AWenzel83/FPGA-Dev/Doc/FPGA_devel.png

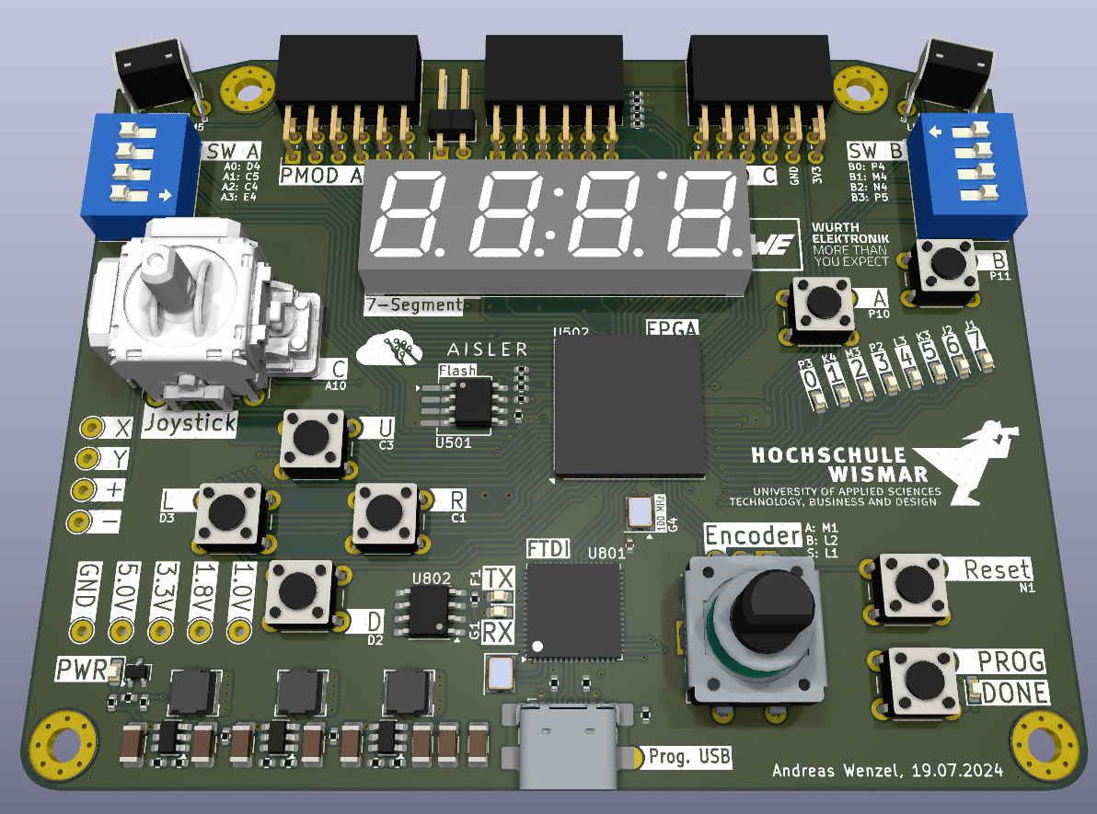
Doc/FPGA_devel.png
