AWenzel83/FPGA-Dev/README.md

# FPGA-Dev
Design and Supportfiles for the FPGA-Dev-Board used in the FPGA-Classes at the HS-Wismar
