AWenzel83/FPGA-Dev/KiCad/steps/RKJXV122400R.STEP

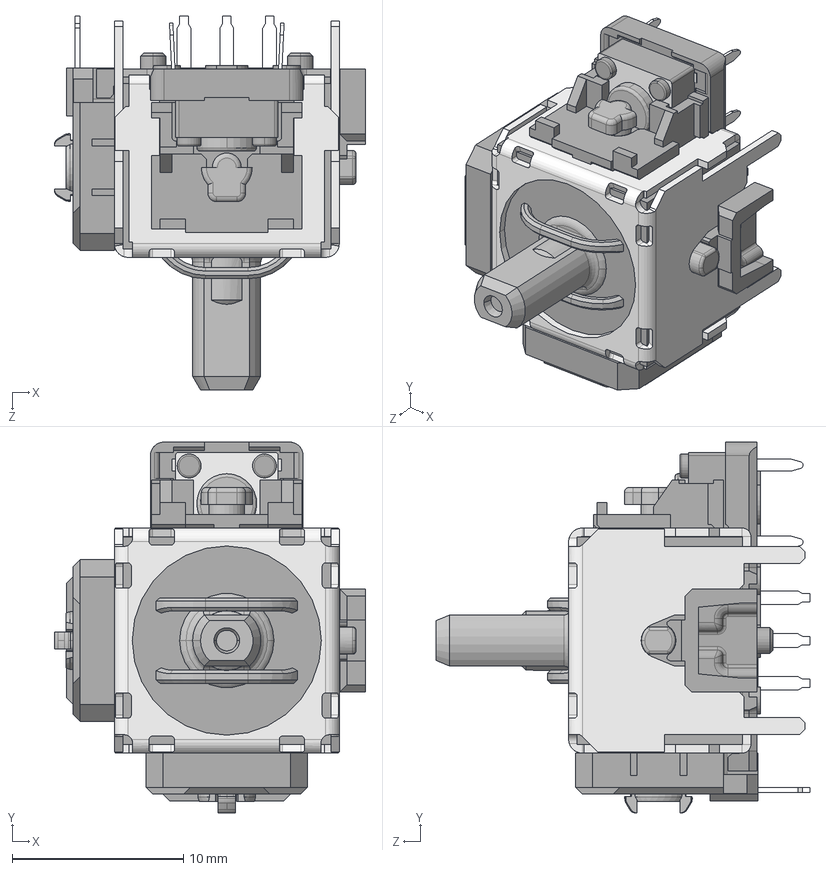
[picture p2: CAD file, 2026-05-18]
KiCad/steps/RKJXV122400R.STEP
18.2 x 21.7 x 21.9 mm
