AWenzel83/FPGA-Dev/KiCad/steps/Download_STP_490107670612 (rev1).stp

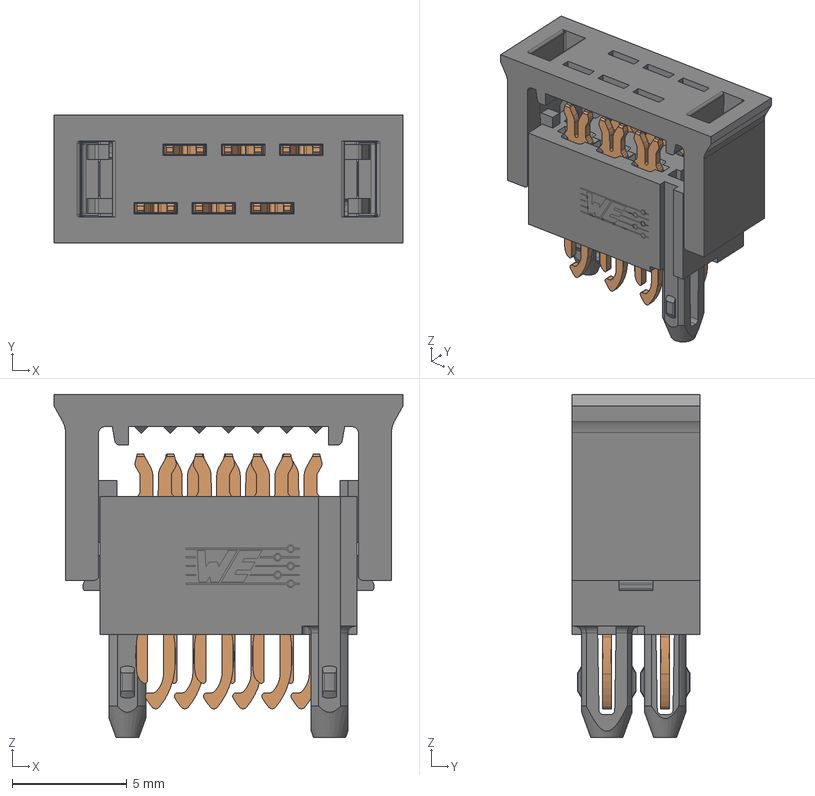
[picture p3: CAD file, 2026-05-18]
KiCad/steps/Download_STP_490107670612 (rev1).stp
15.2 x 5.60 x 15.0 mm
CT422_00.4.1.1_0 x 6
BS698_6_0
BS697_6_0
