AWenzel83/FPGA-Dev/KiCad/steps/Download_STP_693071010811 (rev1).stp

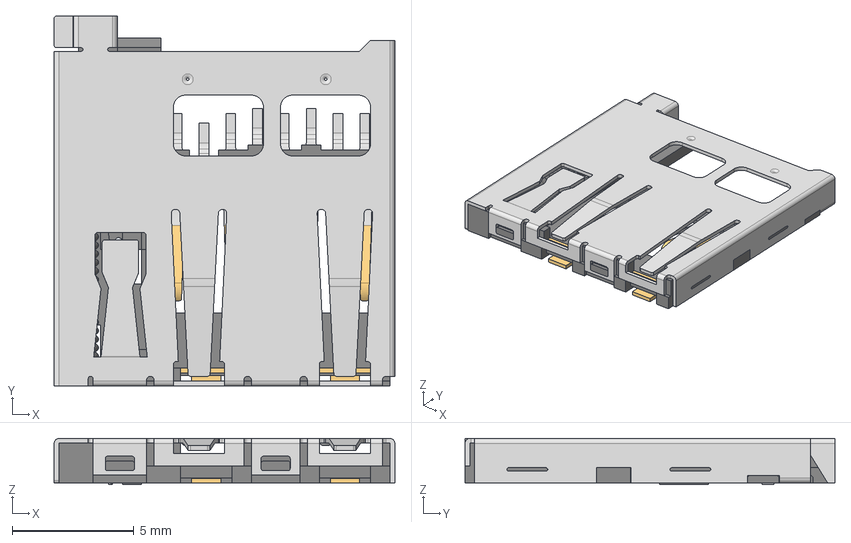
[picture p4: CAD file, 2026-05-18]
KiCad/steps/Download_STP_693071010811 (rev1).stp
14.0 x 15.2 x 1.90 mm
693071010811_COULISSEAU
693071010811_CONTACT x 8
693071010811_AGRAPHE
693071010811_RESSORT
693071010811_CACHE
693071010811_LAME
693071010811_MASSE
