AWenzel83/FPGA-Dev/KiCad/steps/MicroSD_Card.step

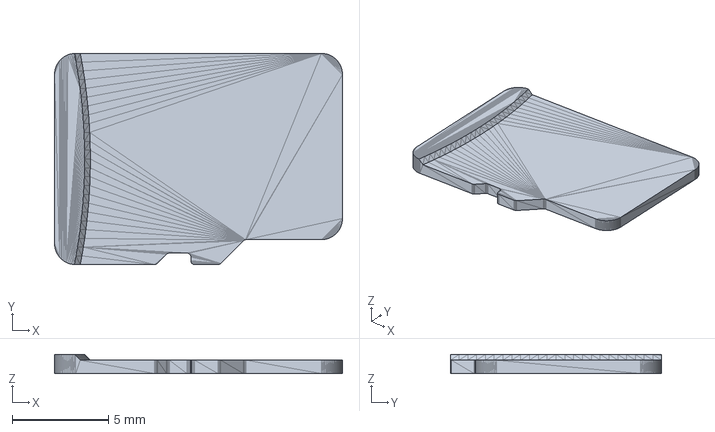
[picture p5: CAD file, 2026-05-18]
KiCad/steps/MicroSD_Card.step
15.0 x 11.0 x 1.00 mm
