AWenzel83/FPGA-Dev/KiCad/steps/USB4110GFA.step

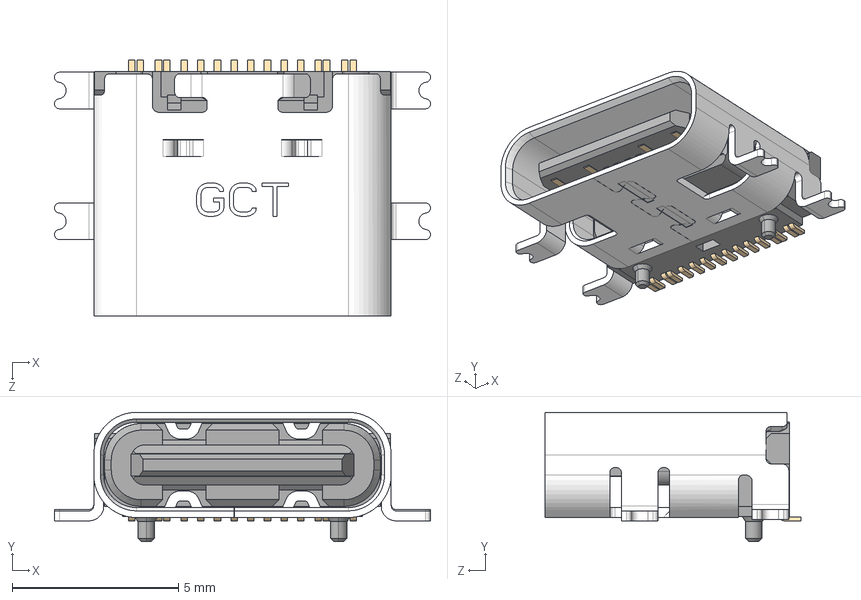
[picture p6: CAD file, 2025-10-09]
KiCad/steps/USB4110GFA.step
11.3 x 3.89 x 7.70 mm
