AWenzel83/FPGA-Dev/KiCad/steps/STP_629722000214 (rev1).stp

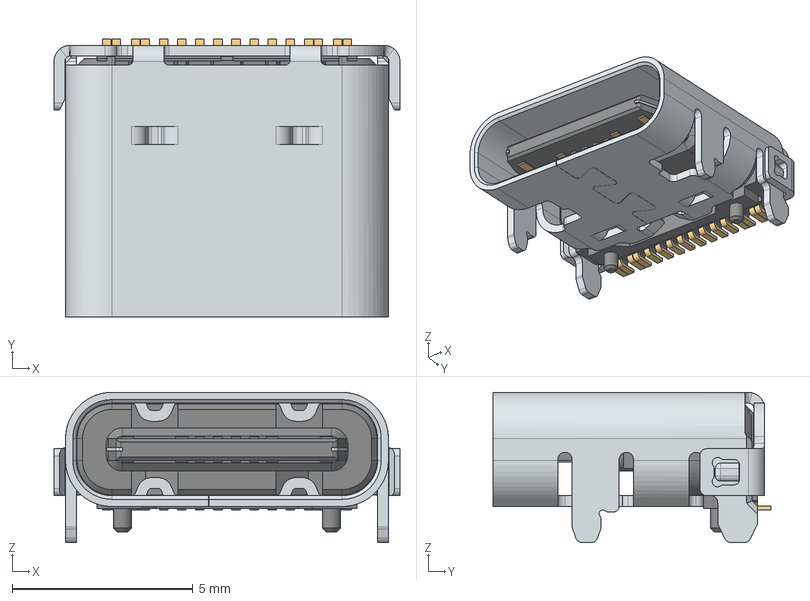
[picture p7: CAD file, 2025-10-09]
KiCad/steps/STP_629722000214 (rev1).stp
9.58 x 7.71 x 4.16 mm
629722000214_Housing
629722000214_Pin1_Top
629722000214_Pin4_Bottom
629722000214_Pin4_Top x 2
629722000214_Pin1_Bottom
629722000214_Pin3_Bottom
629722000214_Pin3_Top
629722000214_Pin2_Top
629722000214_Pin2_Bottom
629722000214_Pin1_Top_mir
629722000214_Pin1_Bottom_mir
629722000214_Pin2_Top_mir
629722000214_Pin2_Bottom_mir
629722000214_Pin3_Top_mir
629722000214_Pin3_Bottom_mir
629722000214_Pin4_Bottom_mir
629722000214_Shielding2
629722000214_Shielding
