AWenzel83/FPGA-Dev/KiCad/steps/FT2232HQ-TRAY--3DModel-STEP-56544.STEP

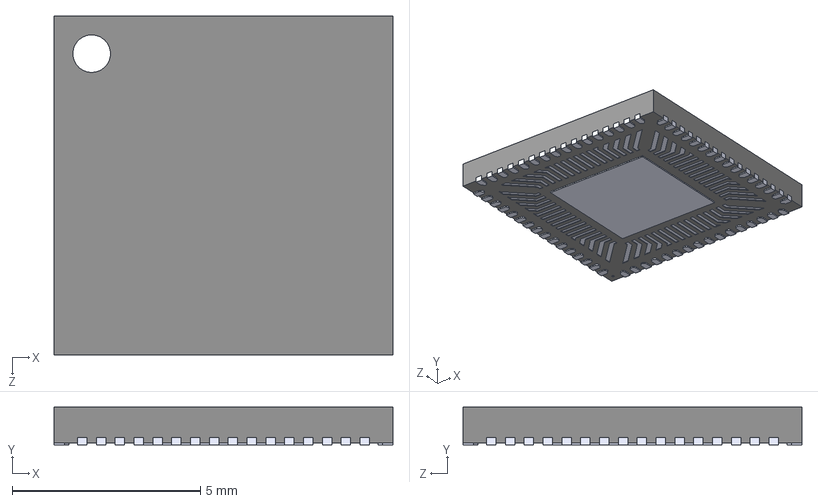
[picture p8: CAD file, 2025-10-09]
KiCad/steps/FT2232HQ-TRAY--3DModel-STEP-56544.STEP
9.00 x 1.00 x 9.00 mm
