AWenzel83/FPGA-Dev/KiCad/steps/Download_STP_482012714003 (rev1).stp

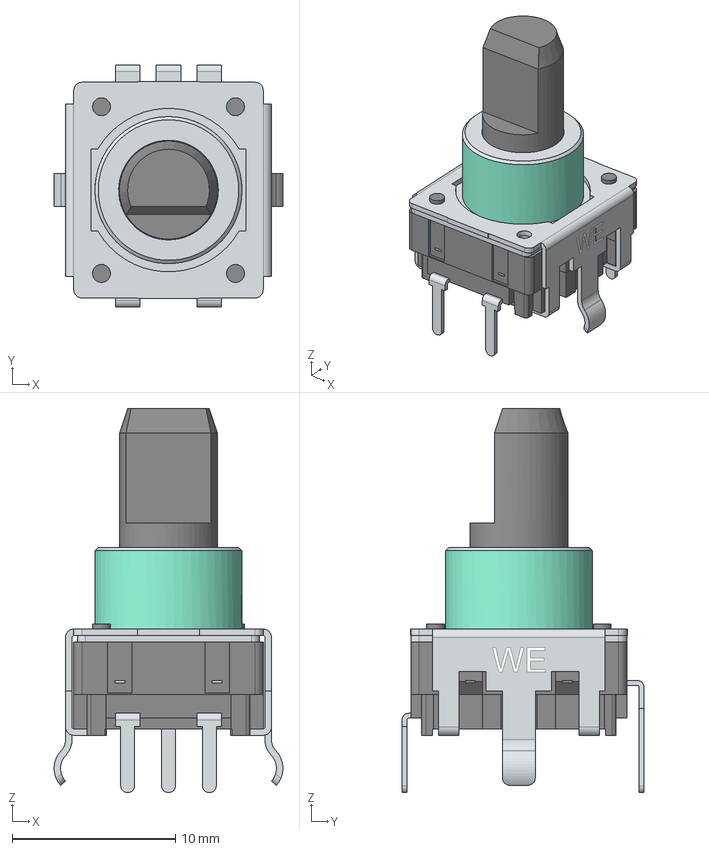
[picture p9: CAD file, 2025-10-09]
KiCad/steps/Download_STP_482012714003 (rev1).stp
14.0 x 14.8 x 23.5 mm
Base
Base_2
contact_plate
Thread
pins_short
pins
pins_2
pins_long
