AWenzel83/FPGA-Dev/KiCad/steps/EC11E-15SW.STEP

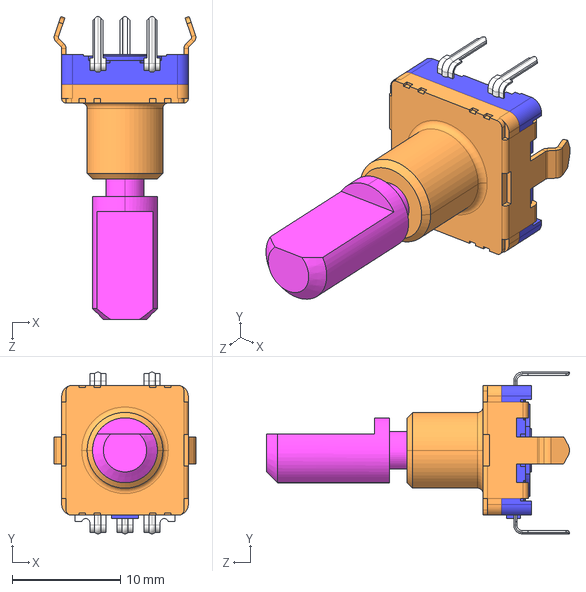
[picture p10: CAD file, 2025-10-09]
KiCad/steps/EC11E-15SW.STEP
13.1 x 14.9 x 28.0 mm
