AWenzel83/FPGA-Dev/KiCad/steps/XC7S50-L1FTGB196I.STEP

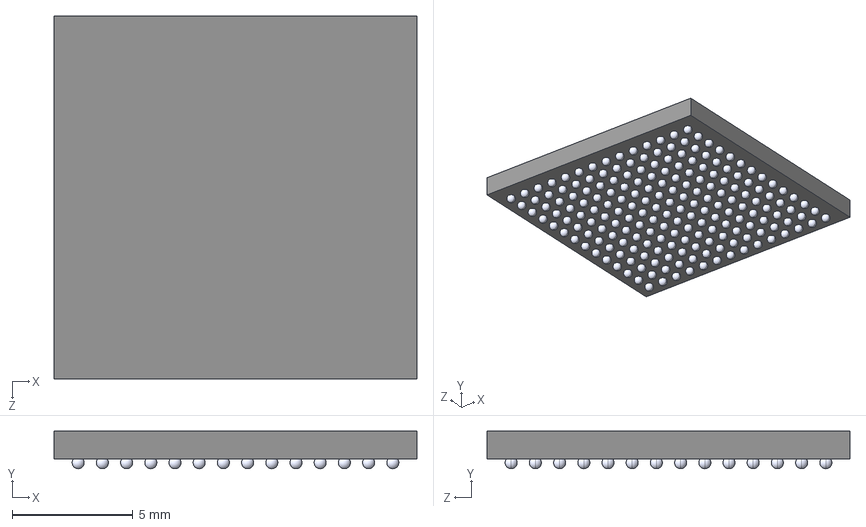
[picture p11: CAD file, 2025-10-09]
KiCad/steps/XC7S50-L1FTGB196I.STEP
15.0 x 1.55 x 15.0 mm
