AWenzel83/FPGA-Dev/KiCad/steps/7M-24.000MBBK-T.STEP

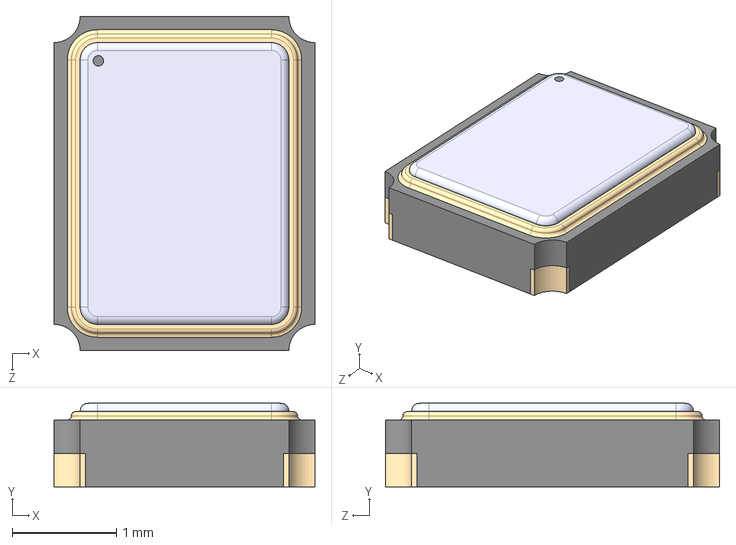
[picture p12: CAD file, 2025-10-09]
KiCad/steps/7M-24.000MBBK-T.STEP
2.50 x 0.8 x 3.20 mm
