AWenzel83/FPGA-Dev/KiCad/steps/430156043736 (rev1).stp

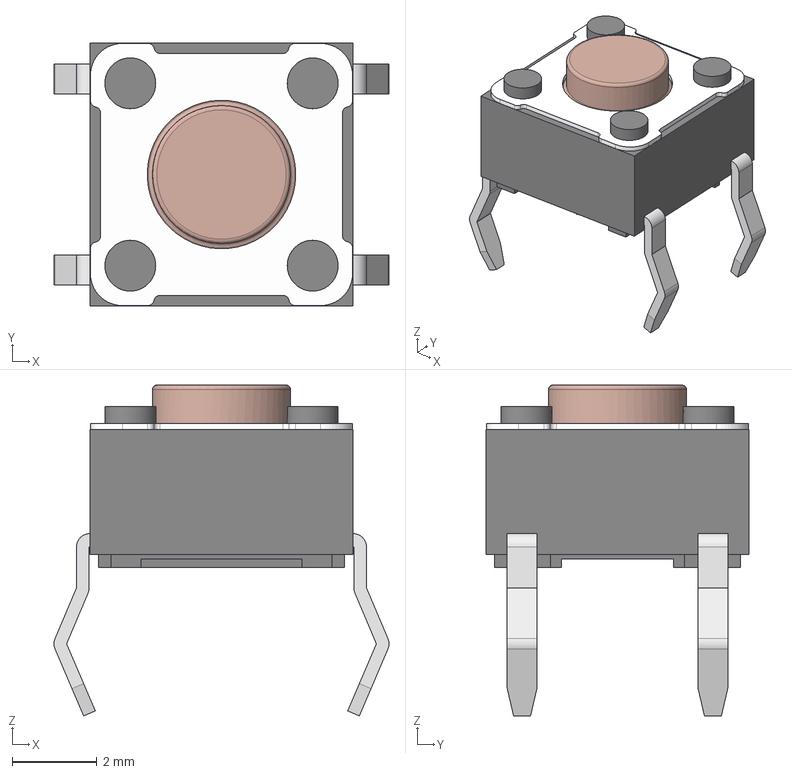
[picture p13: CAD file, 2026-05-18]
KiCad/steps/430156043736 (rev1).stp
7.90 x 6.20 x 7.80 mm
