AWenzel83/FPGA-Dev/KiCad/steps/418117270904 (rev1).stp

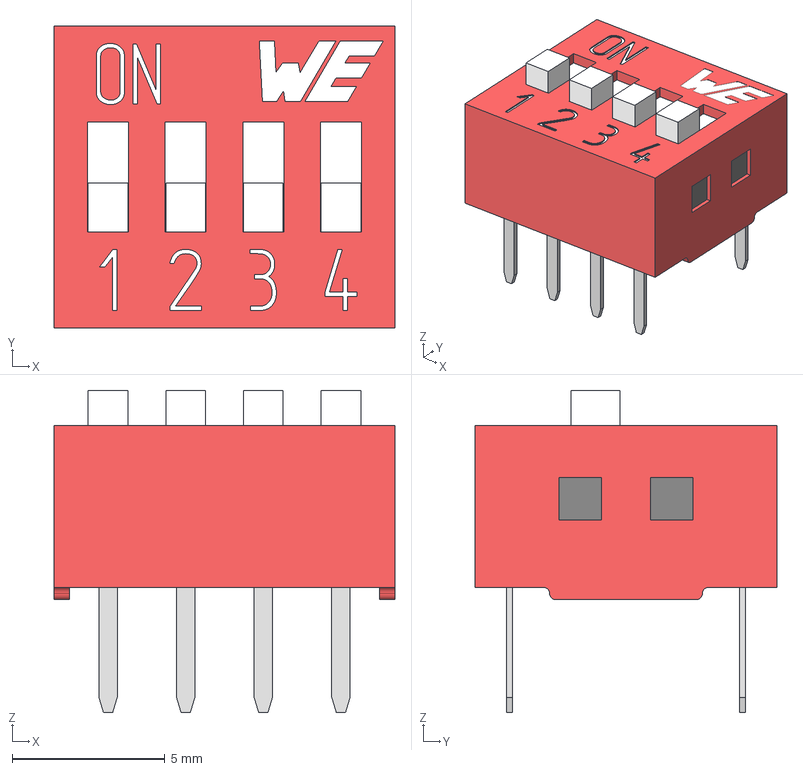
[picture p14: CAD file, 2026-05-18]
KiCad/steps/418117270904 (rev1).stp
11.2 x 9.90 x 10.6 mm
Base_switch
clip x 4
base
