AWenzel83/FPGA-Dev/KiCad/steps/804287_segment_display_10mm_clock.stp

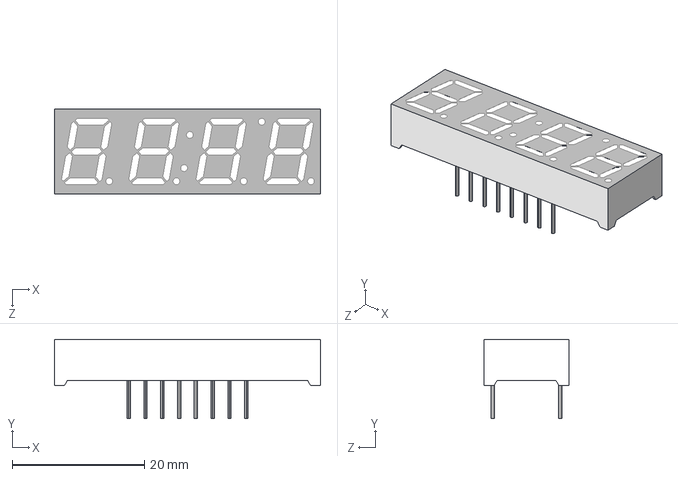
[picture p15: CAD file, 2025-10-09]
KiCad/steps/804287_segment_display_10mm_clock.stp
40.2 x 12.0 x 12.8 mm
