AWenzel83/FPGA-Dev/(list of files, cad)

Other CAD files:
KiCad/steps/RKJXV122400R_gray.STEP
