AWenzel83/FPGA-Dev/Doc/schematic.pdf

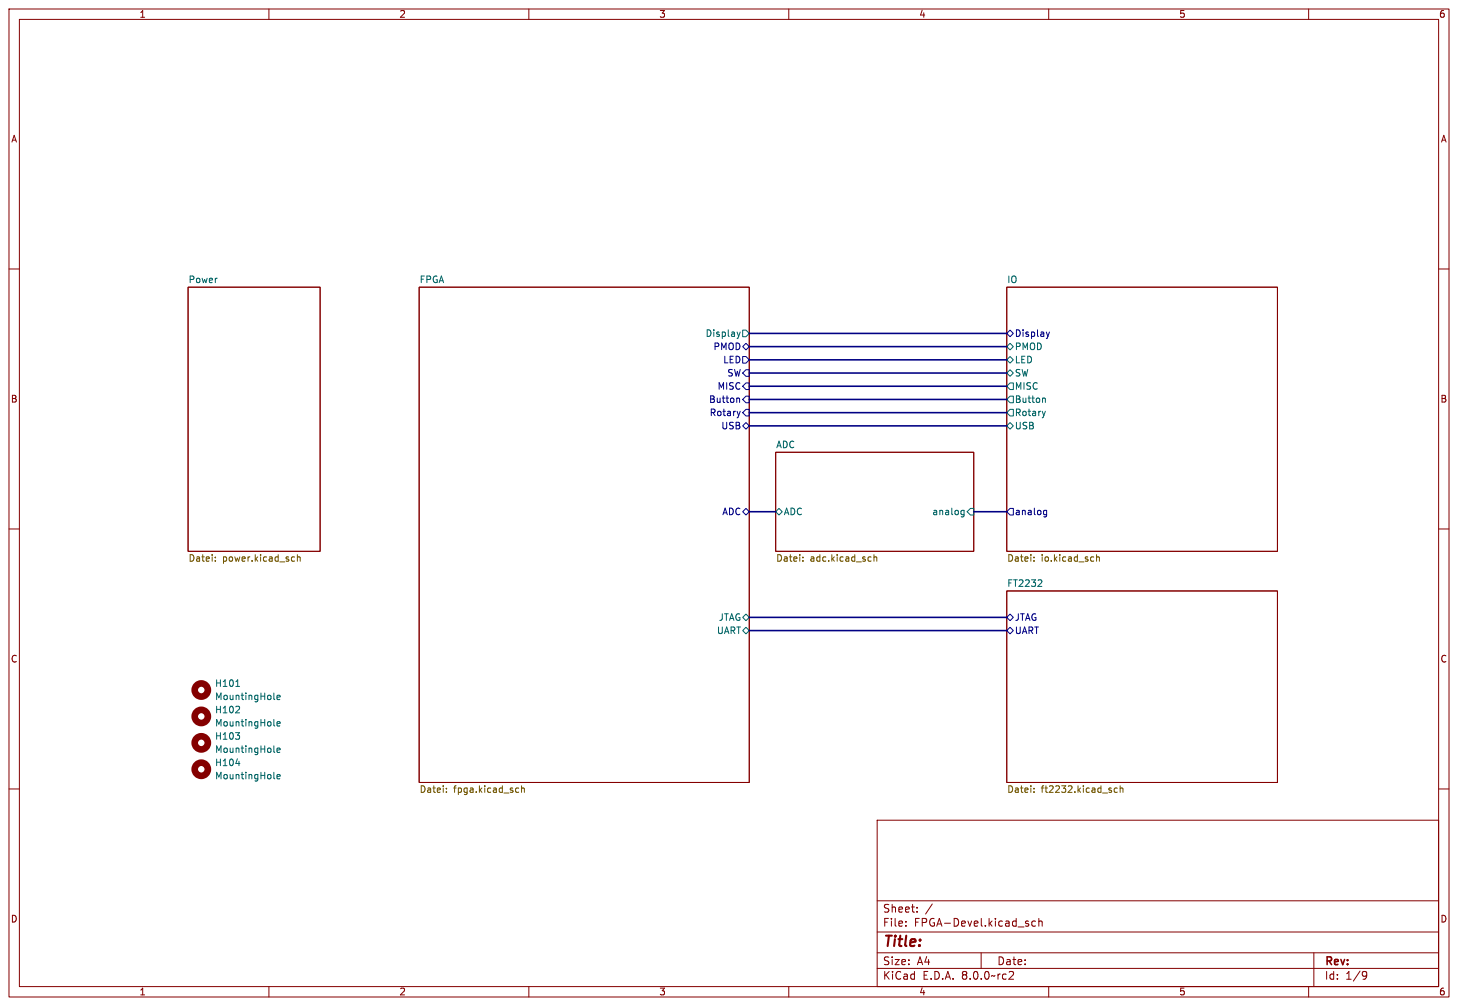
[picture p16: page 1]

FPGA Datei: fpga.kicad_sch H104 MountingHole H103 MountingHole H102 MountingHole H101 MountingHole

Id: 1/9 Title: File: FPGA-Devel.kicad_sch Sheet: /

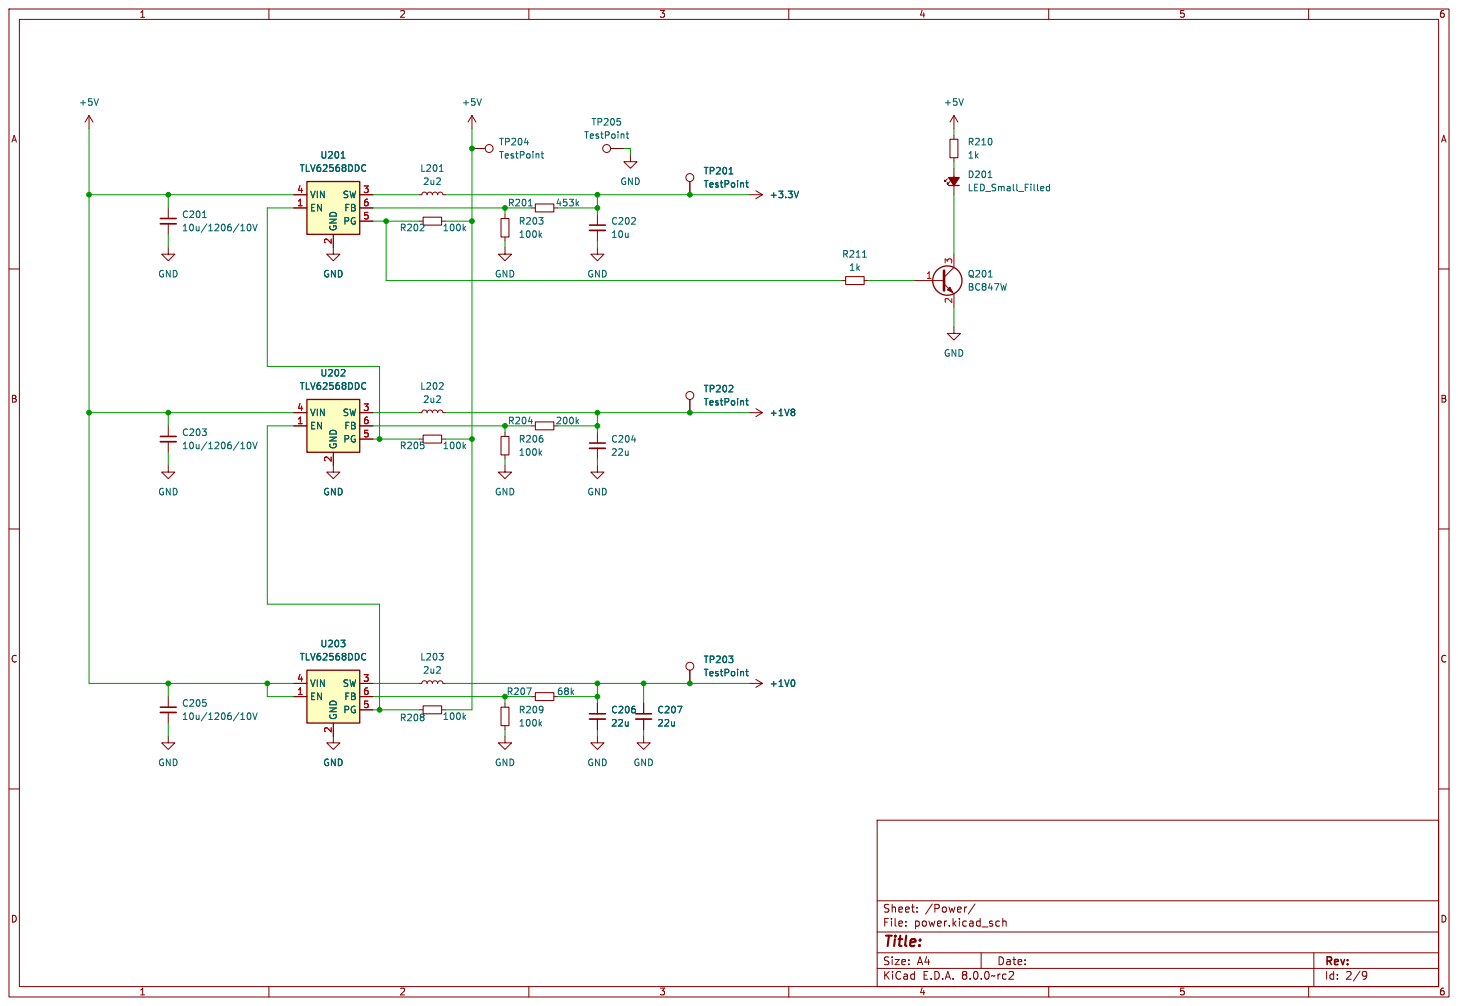
[picture p17: page 2]

2 SW 3 VIN 4 PG 5 FB 6 U201 TLV62568DDC

2 SW 3 VIN 4 PG 5 FB 6 U202 TLV62568DDC GND

2 SW 3 VIN 4 PG 5 FB 6 GND

2 SW 3 VIN 4 PG 5 FB 6 U203 TLV62568DDC GND

2 SW 3 VIN 4 PG 5 FB 6 TP203 TestPoint +1V0 C206

Id: 2/9 Title: File: power.kicad_sch Sheet: /Power/

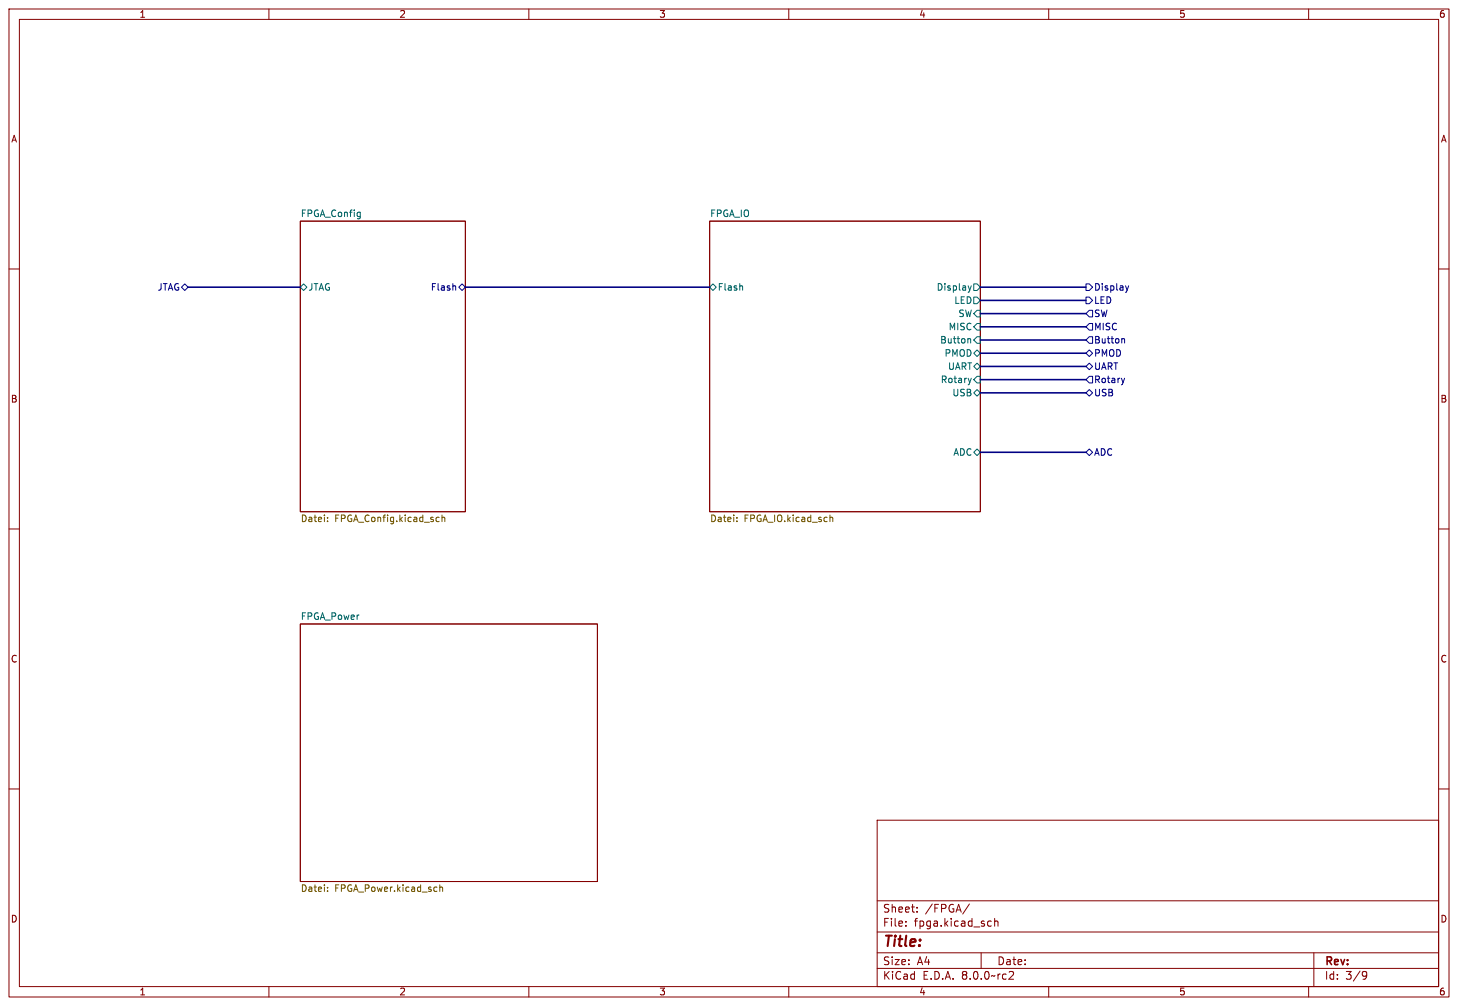
[picture p18: page 3]

Id: 3/9 Title: File: fpga.kicad_sch Sheet: /FPGA/

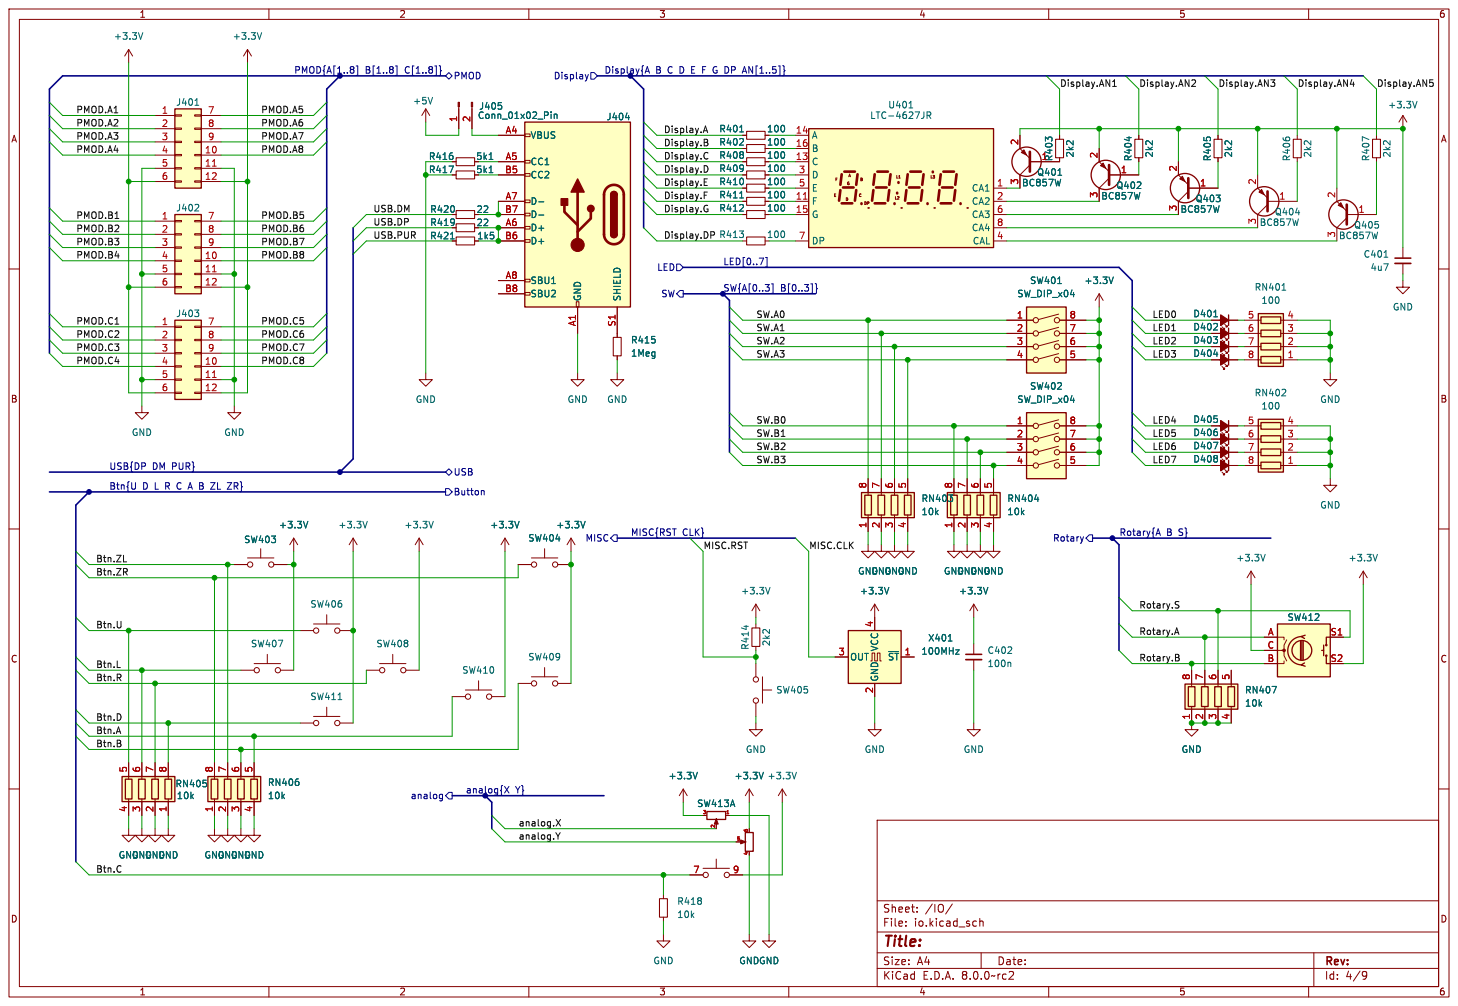
[picture p19: page 4]

J405 Conn_01x02_Pin GND
PMOD.B5 PMOD.B6 PMOD.A7 PMOD.A8 Btn.A

Id: 4/9 Title: File: io.kicad_sch Sheet: /IO/ GND

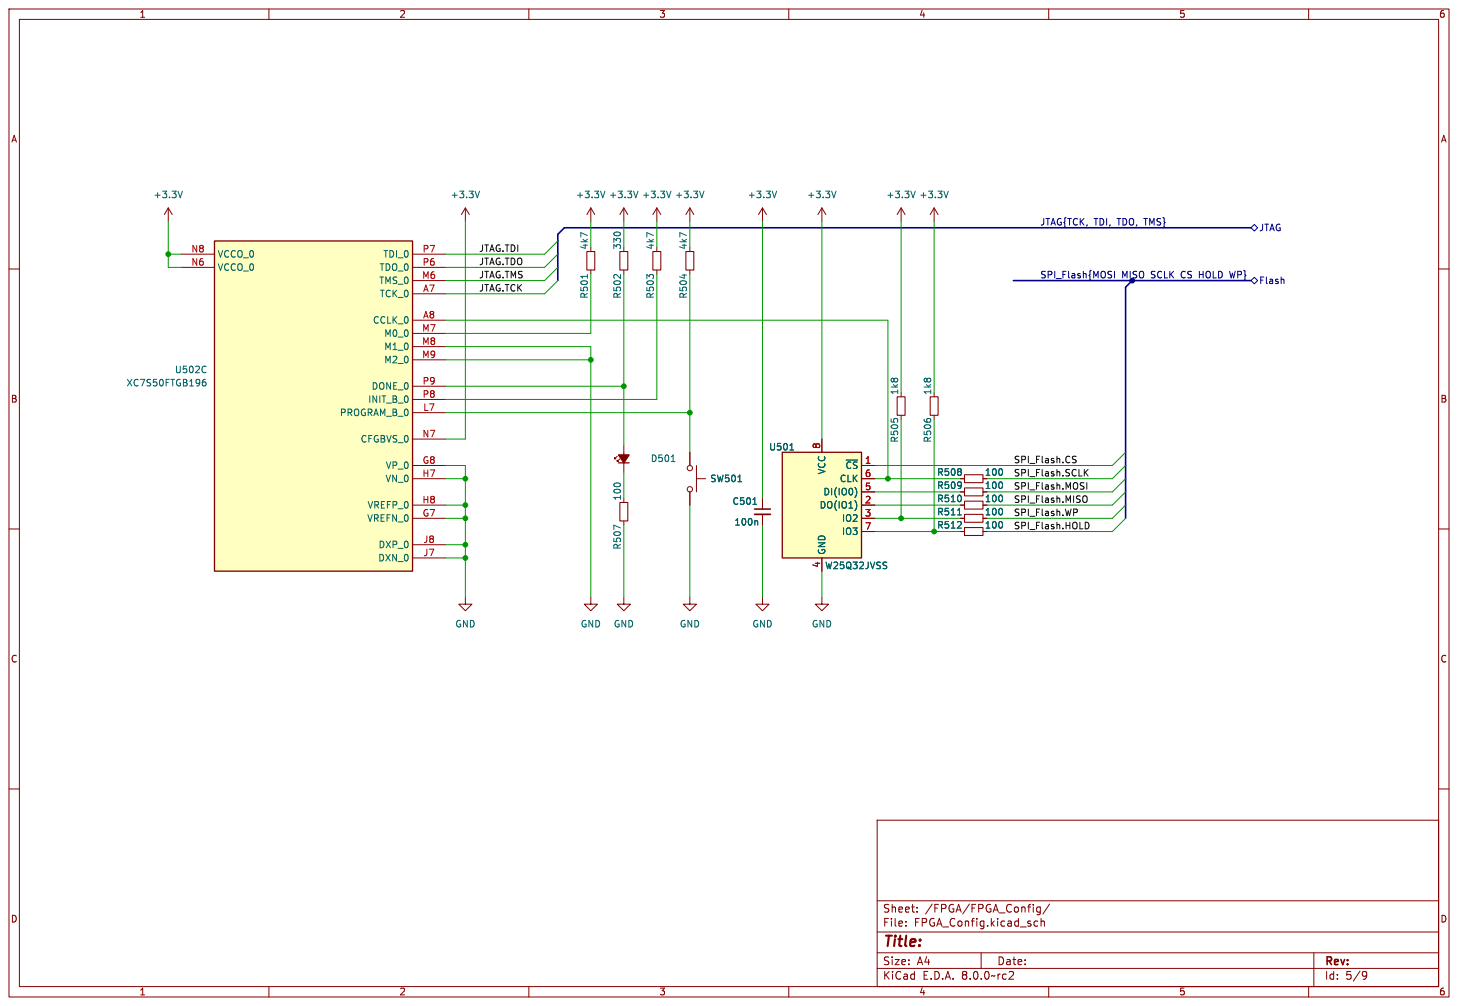
[picture p20: page 5]

JTAG{TCK, TDI, TDO, TMS} SPI_Flash.HOLD

Id: 5/9 Title: File: FPGA_Config.kicad_sch Sheet: /FPGA/FPGA_Config/ C501

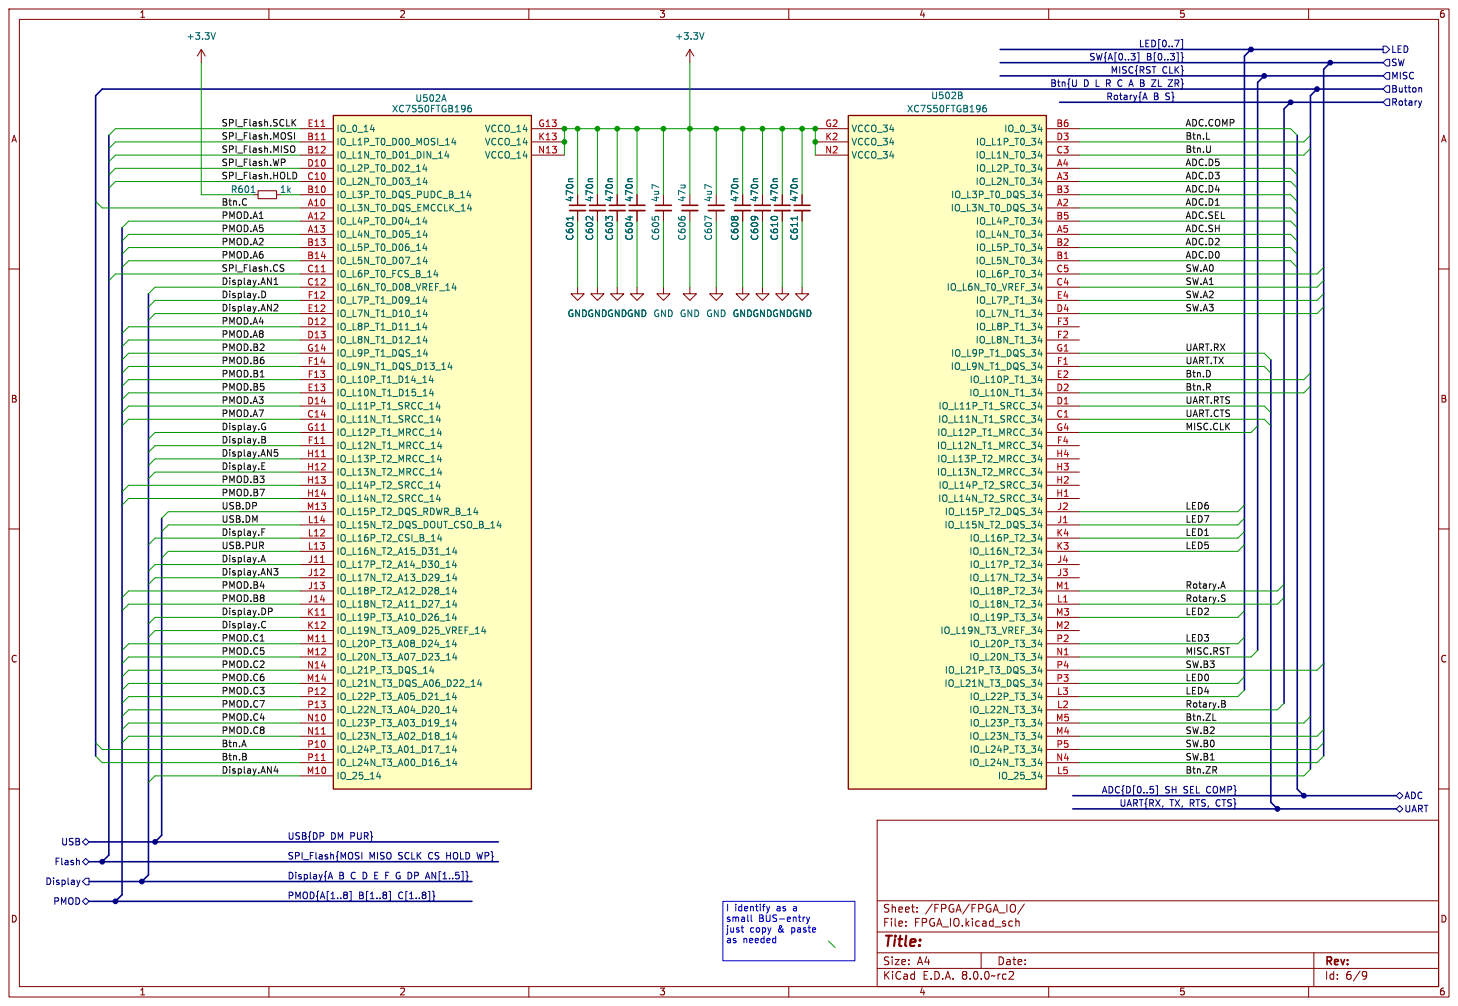
[picture p21: page 6]

LED[0..7] ADC.D4 ADC.D3 ADC.COMP

ADC.D0 MISC{RST CLK}

UART.RX UART.TX
LED6 Rotary.A UART.RTS
LED7 MISC.CLK

LED2 Display.B
SW.B0 Btn.ZL SW.B2 MISC.RST Display.AN5

USB{DP DM PUR}
SPI_Flash{MOSI MISO SCLK CS HOLD WP}

Id: 6/9 Title: File: FPGA_IO.kicad_sch Sheet: /FPGA/FPGA_IO/

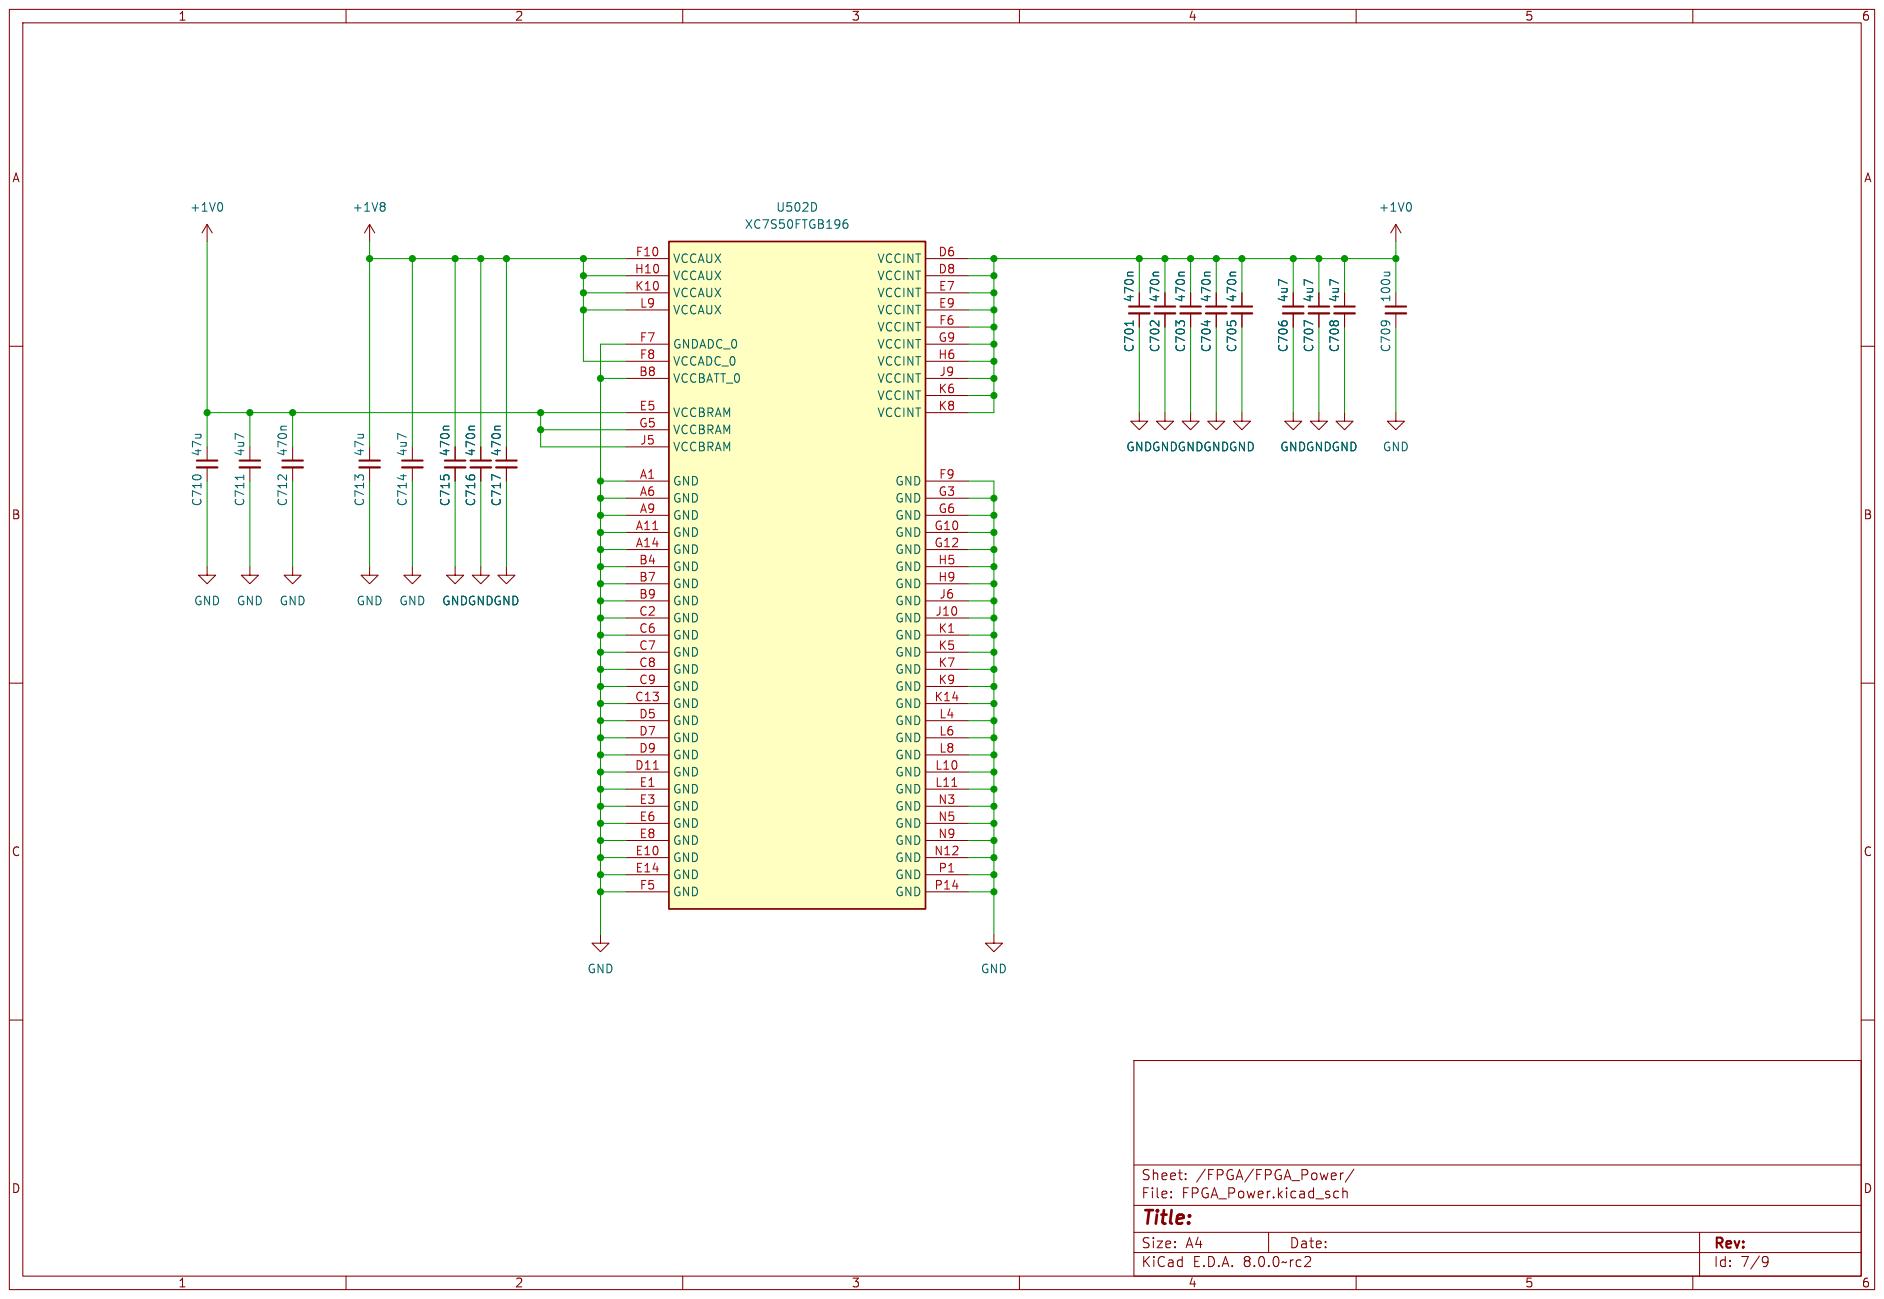
[picture p22: page 7]

Id: 7/9 Title: File: FPGA_Power.kicad_sch Sheet: /FPGA/FPGA_Power/ C702 470n GNDGNDGNDGNDC705 470n C704 470n C703 470n GND GND GND GND

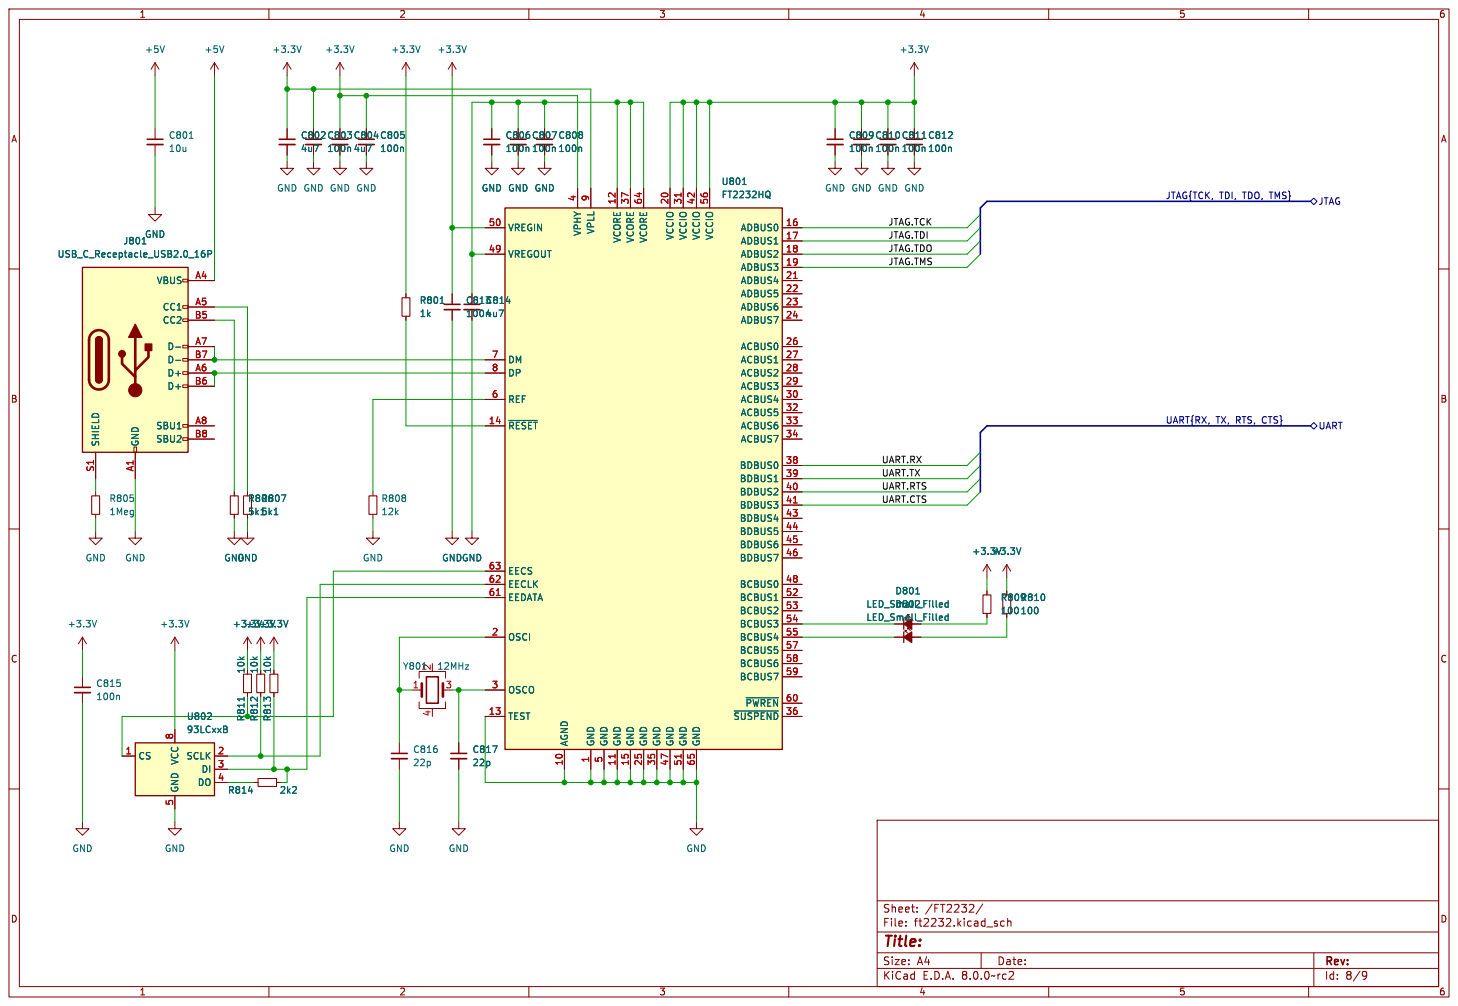
[picture p23: page 8]

GND
JTAG{TCK, TDI, TDO, TMS} JTAG.TDO
JTAG.TMS UART.CTS

1 AGND 10 GND 11 VCORE 12 TEST 13 ~{RESET} 14 GND 15 ADBUS0 16 ADBUS1 17 ADBUS2 18 ADBUS3 19 OSCI 2 VCCIO 20 ADBUS4 21 ADBUS5 22 ADBUS6 23 ADBUS7 24 GND 25 ACBUS0 26 ACBUS1 27 ACBUS2 28 ACBUS3 29 OSCO 3 ACBUS4 30 VCCIO 31 ACBUS5 32 ACBUS6 33 ACBUS7 34 GND 35

4 BDBUS2 40 BDBUS3 41 VCCIO 42 BDBUS4 43 BDBUS5 44 BDBUS6 45 BDBUS7 46 GND 47 BCBUS0 48 VREGOUT 49 GND

5 VREGIN 50 GND 51 BCBUS1 52 BCBUS2 53 BCBUS3 54 BCBUS4 55 VCCIO 56 BCBUS5 57 BCBUS6 58 BCBUS7 59 REF 6 ~{PWREN}60 EEDATA 61 EECLK 62 EECS 63 VCORE 64 GND 65 DM 7 DP 8 VPLL

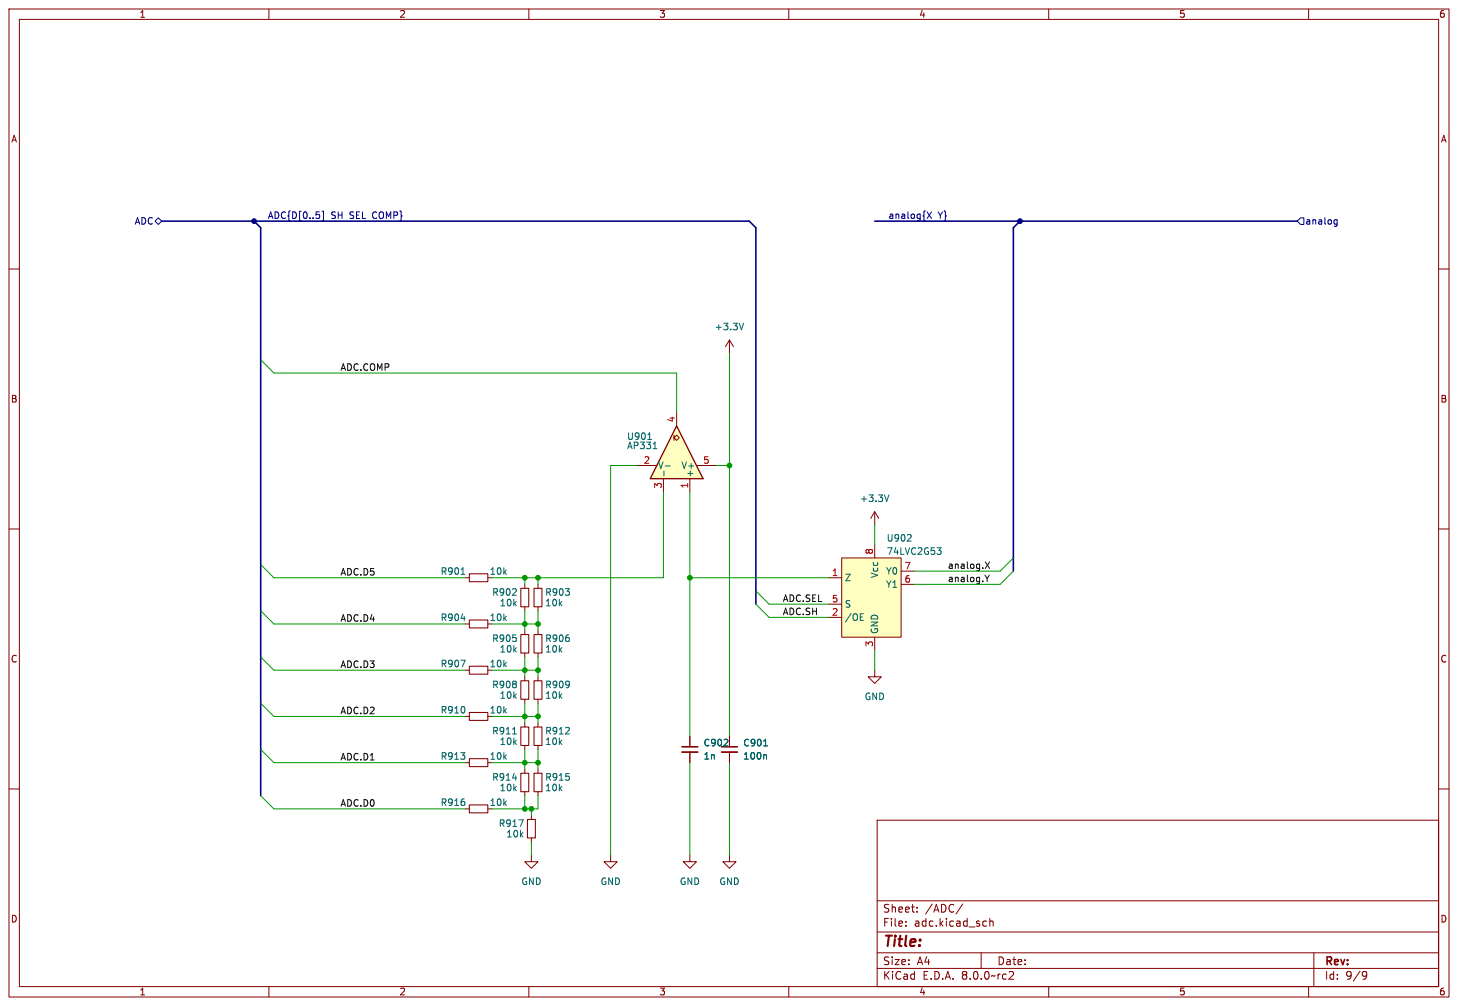
[picture p24: page 9]
