AWenzel83/FPGA-Dev/KiCad/FPGA-Devel.kicad_pcb

## KiCad design KiCad/FPGA-Devel.kicad_pcb (2026-06-23)

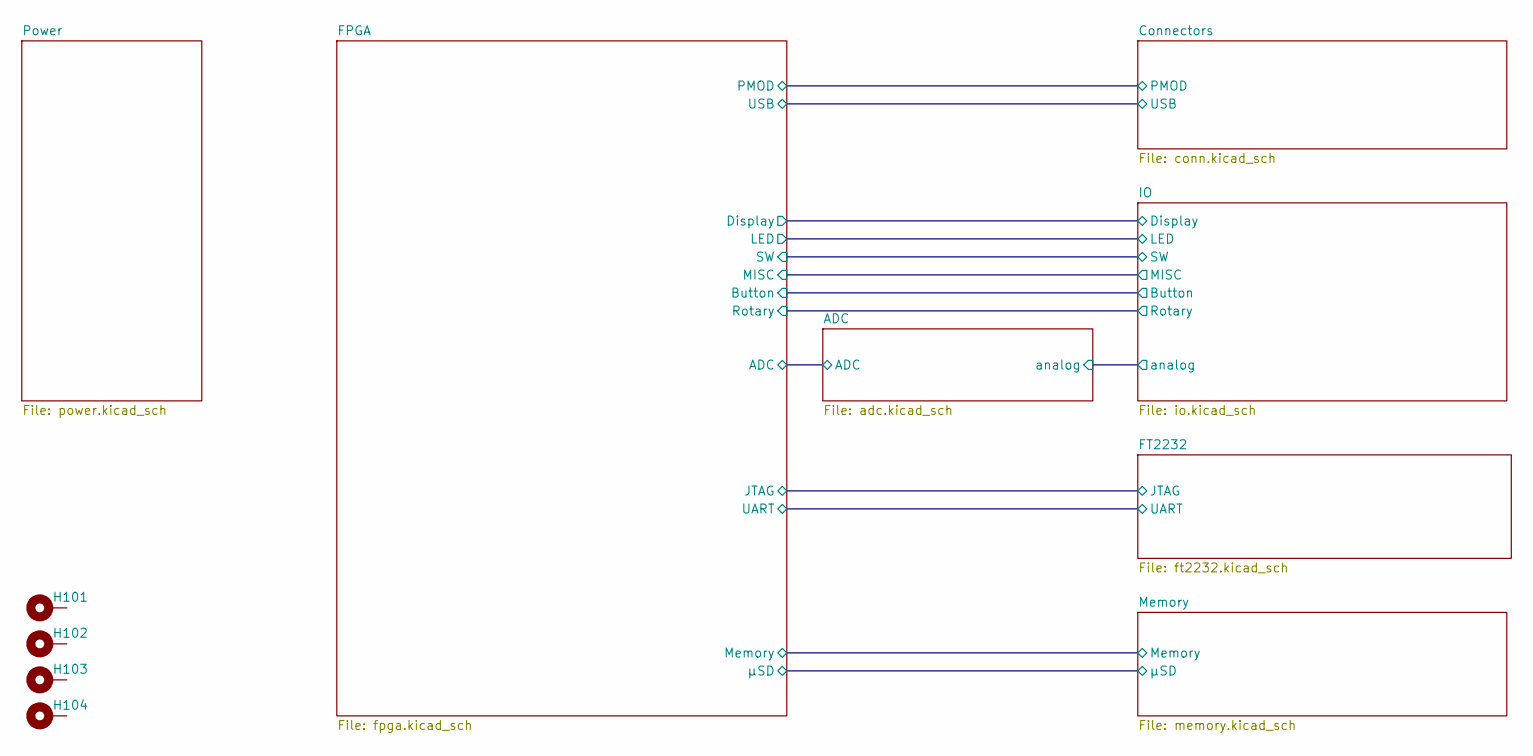
[picture p25: schematic FPGA-Devel.kicad_sch]

Parts:
H101, H102, H103, H104: MountingHole_Pad; MountingHole_3.2mm_M3_Pad_Via

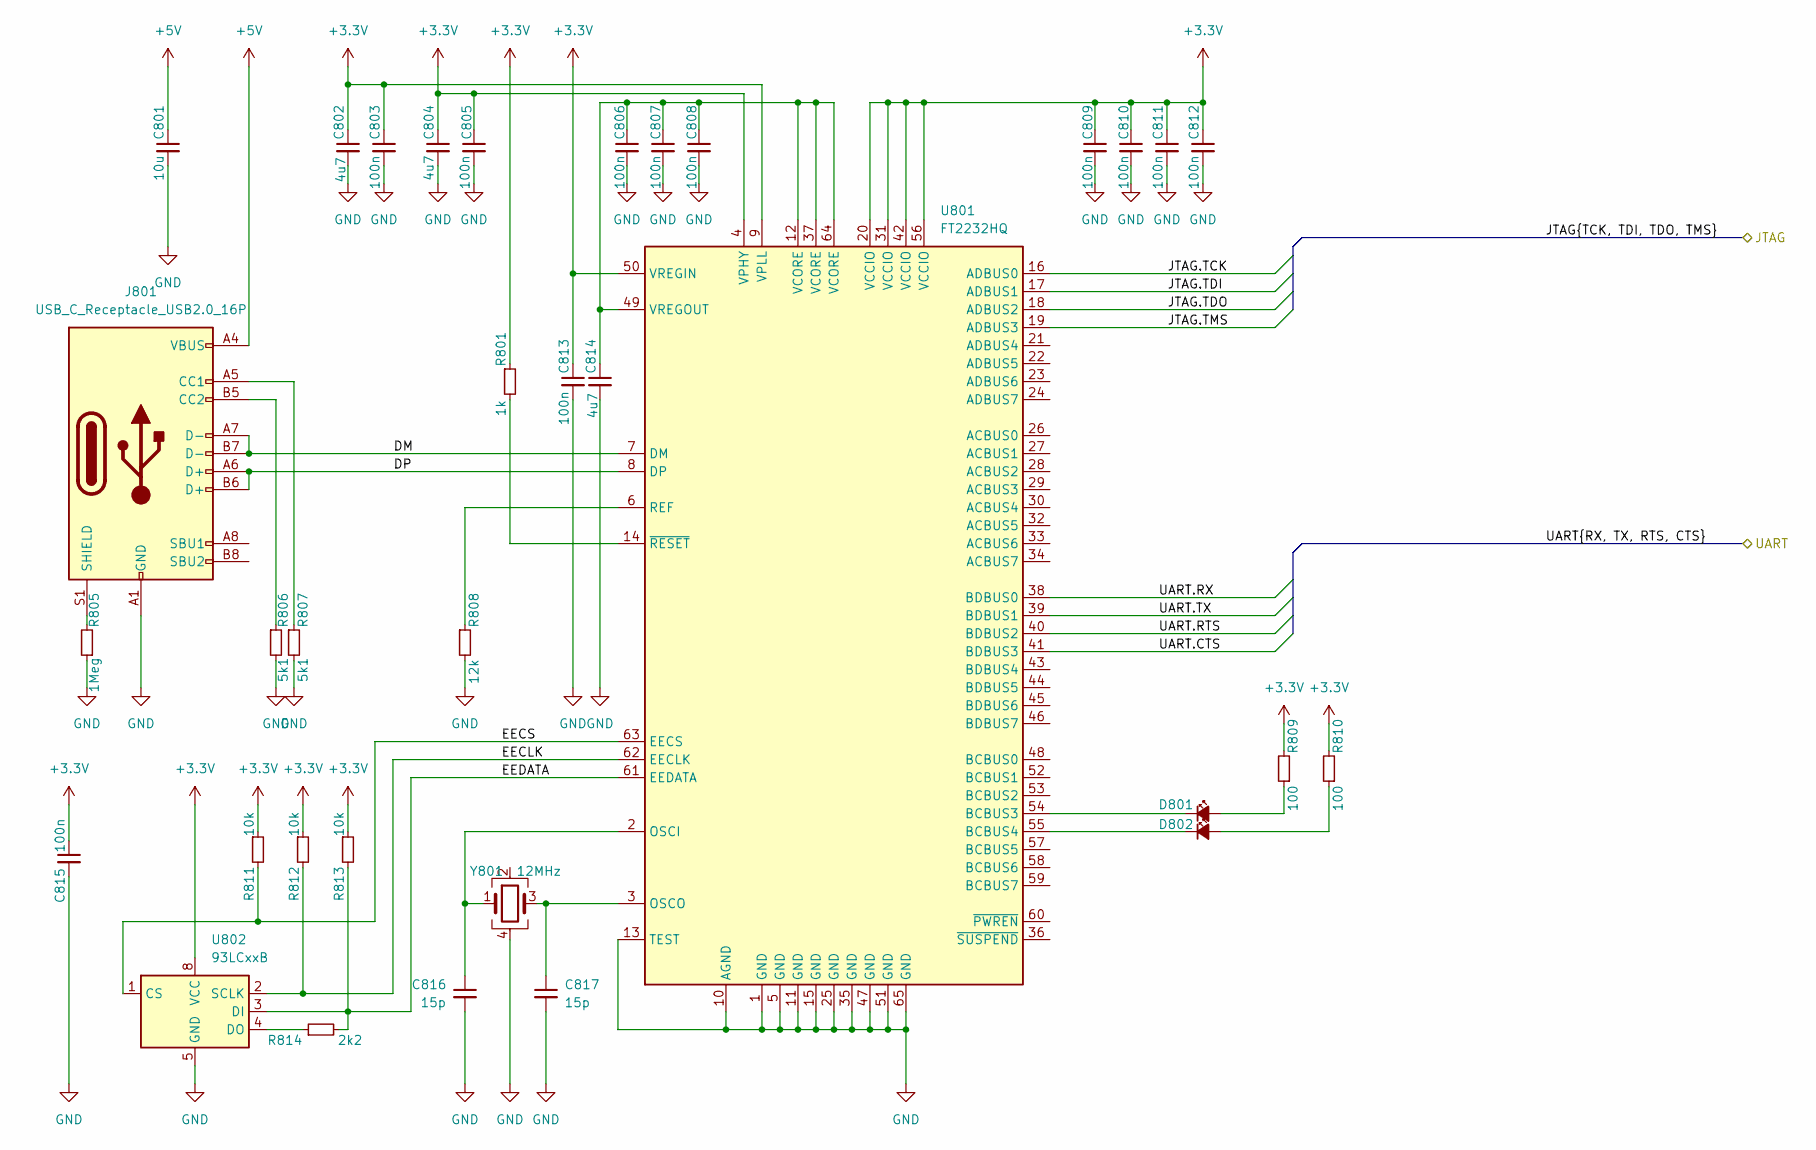
[picture p26: schematic ft2232.kicad_sch]

Parts:
C801: 10u; C_1206_3216Metric
C802, C804, C814: 4u7; C_0603_1608Metric
C803, C805, C806, C807, C808, C809, C810, C811, C812, C813, C815: 100n; C_0402_1005Metric
C816, C817: 15p; C_0402_1005Metric
D801, D802: LED_Small_Filled; LED_0603_1608Metric
J801: USB_C_Receptacle_USB2.0_16P; USB_C_Combo
R801: 1k; R_0402_1005Metric
R805: 1Meg; R_0402_1005Metric
R806, R807: 5k1; R_0402_1005Metric
R808: 12k; R_0402_1005Metric
R809, R810: 100; R_0402_1005Metric
R811, R812, R813: 10k; R_0402_1005Metric
R814: 2k2; R_0402_1005Metric
U801: FT2232HQ; QFN-64-1EP_9x9mm_P0.5mm_EP4.35x4.35mm
U802: 93LCxxB; SOIC-8_3.9x4.9mm_P1.27mm
Y801: 12MHz; Oscillator_SMD_Abracon_ASE-4Pin_3.2x2.5mm

Connections:
+3.3V: C802.1, C803.1, C804.1, C805.1, C809.1, C810.1, C811.1, C812.1, C813.1, C815.1, R801.1, R809.2, R810.2, R811.1, R812.1, R813.1, U801.4 (VPHY), U801.9 (VPLL), U801.20 (VCCIO), U801.31 (VCCIO), U801.42 (VCCIO), U801.50 (VREGIN), U801.56 (VCCIO), U802.8 (VCC); also elsewhere on the board
+5V: C801.1, J801.A4 (VBUS), J801.A9 (VBUS), J801.B4 (VBUS), J801.B9 (VBUS); also elsewhere on the board
/FT2232/DM: J801.A7 (D-), J801.B7 (D-), U801.7 (DM)
/FT2232/DP: J801.A6 (D+), J801.B6 (D+), U801.8 (DP)
/FT2232/EECLK: R812.2, U801.62 (EECLK), U802.2 (SCLK)
/FT2232/EECS: R811.2, U801.63 (EECS), U802.1 (CS)
/FT2232/EEDATA: R813.2, R814.2, U801.61 (EEDATA), U802.3 (DI)
/FT2232/JTAG.TCK: U801.16 (ADBUS0); also elsewhere on the board
/FT2232/JTAG.TDI: U801.17 (ADBUS1); also elsewhere on the board
/FT2232/JTAG.TDO: U801.18 (ADBUS2); also elsewhere on the board
/FT2232/JTAG.TMS: U801.19 (ADBUS3); also elsewhere on the board
/FT2232/UART.CTS: U801.41 (BDBUS3); also elsewhere on the board
/FT2232/UART.RTS: U801.40 (BDBUS2); also elsewhere on the board
/FT2232/UART.RX: U801.38 (BDBUS0); also elsewhere on the board
/FT2232/UART.TX: U801.39 (BDBUS1); also elsewhere on the board
GND: C801.2, C802.2, C803.2, C804.2, C805.2, C806.2, C807.2, C808.2, C809.2, C810.2, C811.2, C812.2, C813.2, C814.2, C815.2, C816.2, C817.2, J801.A1 (GND), J801.A12 (GND), J801.B1 (GND), J801.B12 (GND), R805.1, R806.2, R807.2, R808.2, U801.1 (GND), U801.5 (GND), U801.10 (AGND), U801.11 (GND), U801.13 (TEST), U801.15 (GND), U801.25 (GND), U801.35 (GND), U801.47 (GND), U801.51 (GND), U801.65 (GND), U802.5 (GND), Y801.4; also elsewhere on the board
unnamed: D801.2 (A), R809.1
unnamed: D801.1 (K), U801.54 (BCBUS3)
unnamed: D802.2 (A), R810.1
unnamed: D802.1 (K), U801.55 (BCBUS4)
unnamed: J801.A5 (CC1), R807.1
unnamed: J801.B5 (CC2), R806.1
unnamed: J801.S1 (SHIELD), R805.2
unnamed: C816.1, U801.2 (OSCI), Y801.1
unnamed: C817.1, U801.3 (OSCO), Y801.3
unnamed: R808.1, U801.6 (REF)
unnamed: C806.1, C807.1, C808.1, C814.1, U801.12 (VCORE), U801.37 (VCORE), U801.49 (VREGOUT), U801.64 (VCORE)
unnamed: R801.2, U801.14 (~RESET)
unnamed: R814.1, U802.4 (DO)

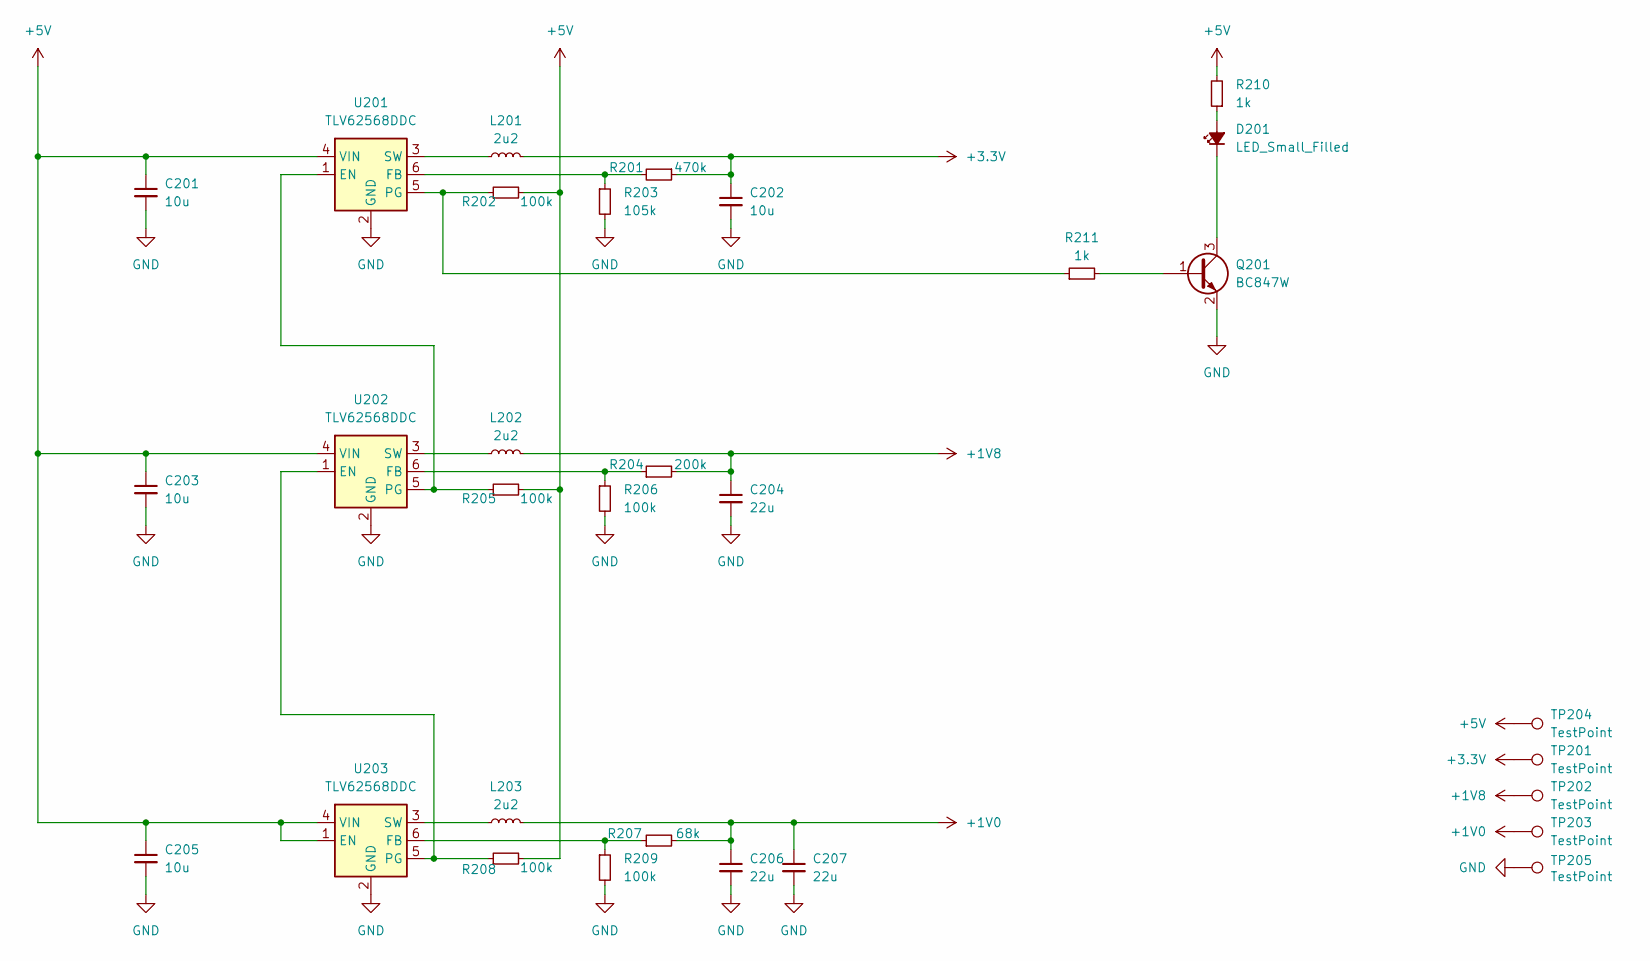
[picture p27: schematic power.kicad_sch]

Parts:
C201, C202, C203, C205: 10u; C_1206_3216Metric
C204, C206, C207: 22u; C_1206_3216Metric
D201: LED_Small_Filled; LED_0603_1608Metric
L201, L202, L203: 2u2; L_Bourns-SRN4018
Q201: BC847W; SOT-23-3
R201: 470k; R_0402_1005Metric
R202, R205, R206, R208, R209: 100k; R_0402_1005Metric
R203: 105k; R_0402_1005Metric
R204: 200k; R_0402_1005Metric
R207: 68k; R_0402_1005Metric
R210, R211: 1k; R_0402_1005Metric
TP201, TP202, TP203, TP204, TP205: TestPoint; TestPoint_THTPad_D2.0mm_Drill1.0mm
U201, U202, U203: TLV62568DDC; SOT-23-6

Connections:
+1V0: C206.1, C207.1, L203.2, R207.2, TP203.1 (1_1); also elsewhere on the board
+1V8: C204.1, L202.2, R204.2, TP202.1 (1_1); also elsewhere on the board
+3.3V: C202.1, L201.2, R201.1, TP201.1 (1_1); also elsewhere on the board
+5V: C201.1, C203.1, C205.1, R202.2, R205.2, R208.2, R210.2, TP204.1 (1_1), U201.4 (VIN), U202.4 (VIN), U203.1 (EN), U203.4 (VIN); also elsewhere on the board
GND: C201.2, C202.2, C203.2, C204.2, C205.2, C206.2, C207.2, Q201.2 (E), R203.2, R206.2, R209.2, TP205.1 (1_1), U201.2 (GND), U202.2 (GND), U203.2 (GND); also elsewhere on the board
unnamed: D201.2 (A), R210.1
unnamed: D201.1 (K), Q201.3 (C)
unnamed: Q201.1 (B), R211.2
unnamed: R205.1, U201.1 (EN), U202.5 (PG)
unnamed: R201.2, R203.1, U201.6 (FB)
unnamed: R202.1, R211.1, U201.5 (PG)
unnamed: L201.1, U201.3 (SW)
unnamed: R208.1, U202.1 (EN), U203.5 (PG)
unnamed: R204.1, R206.1, U202.6 (FB)
unnamed: L202.1, U202.3 (SW)
unnamed: R207.1, R209.1, U203.6 (FB)
unnamed: L203.1, U203.3 (SW)

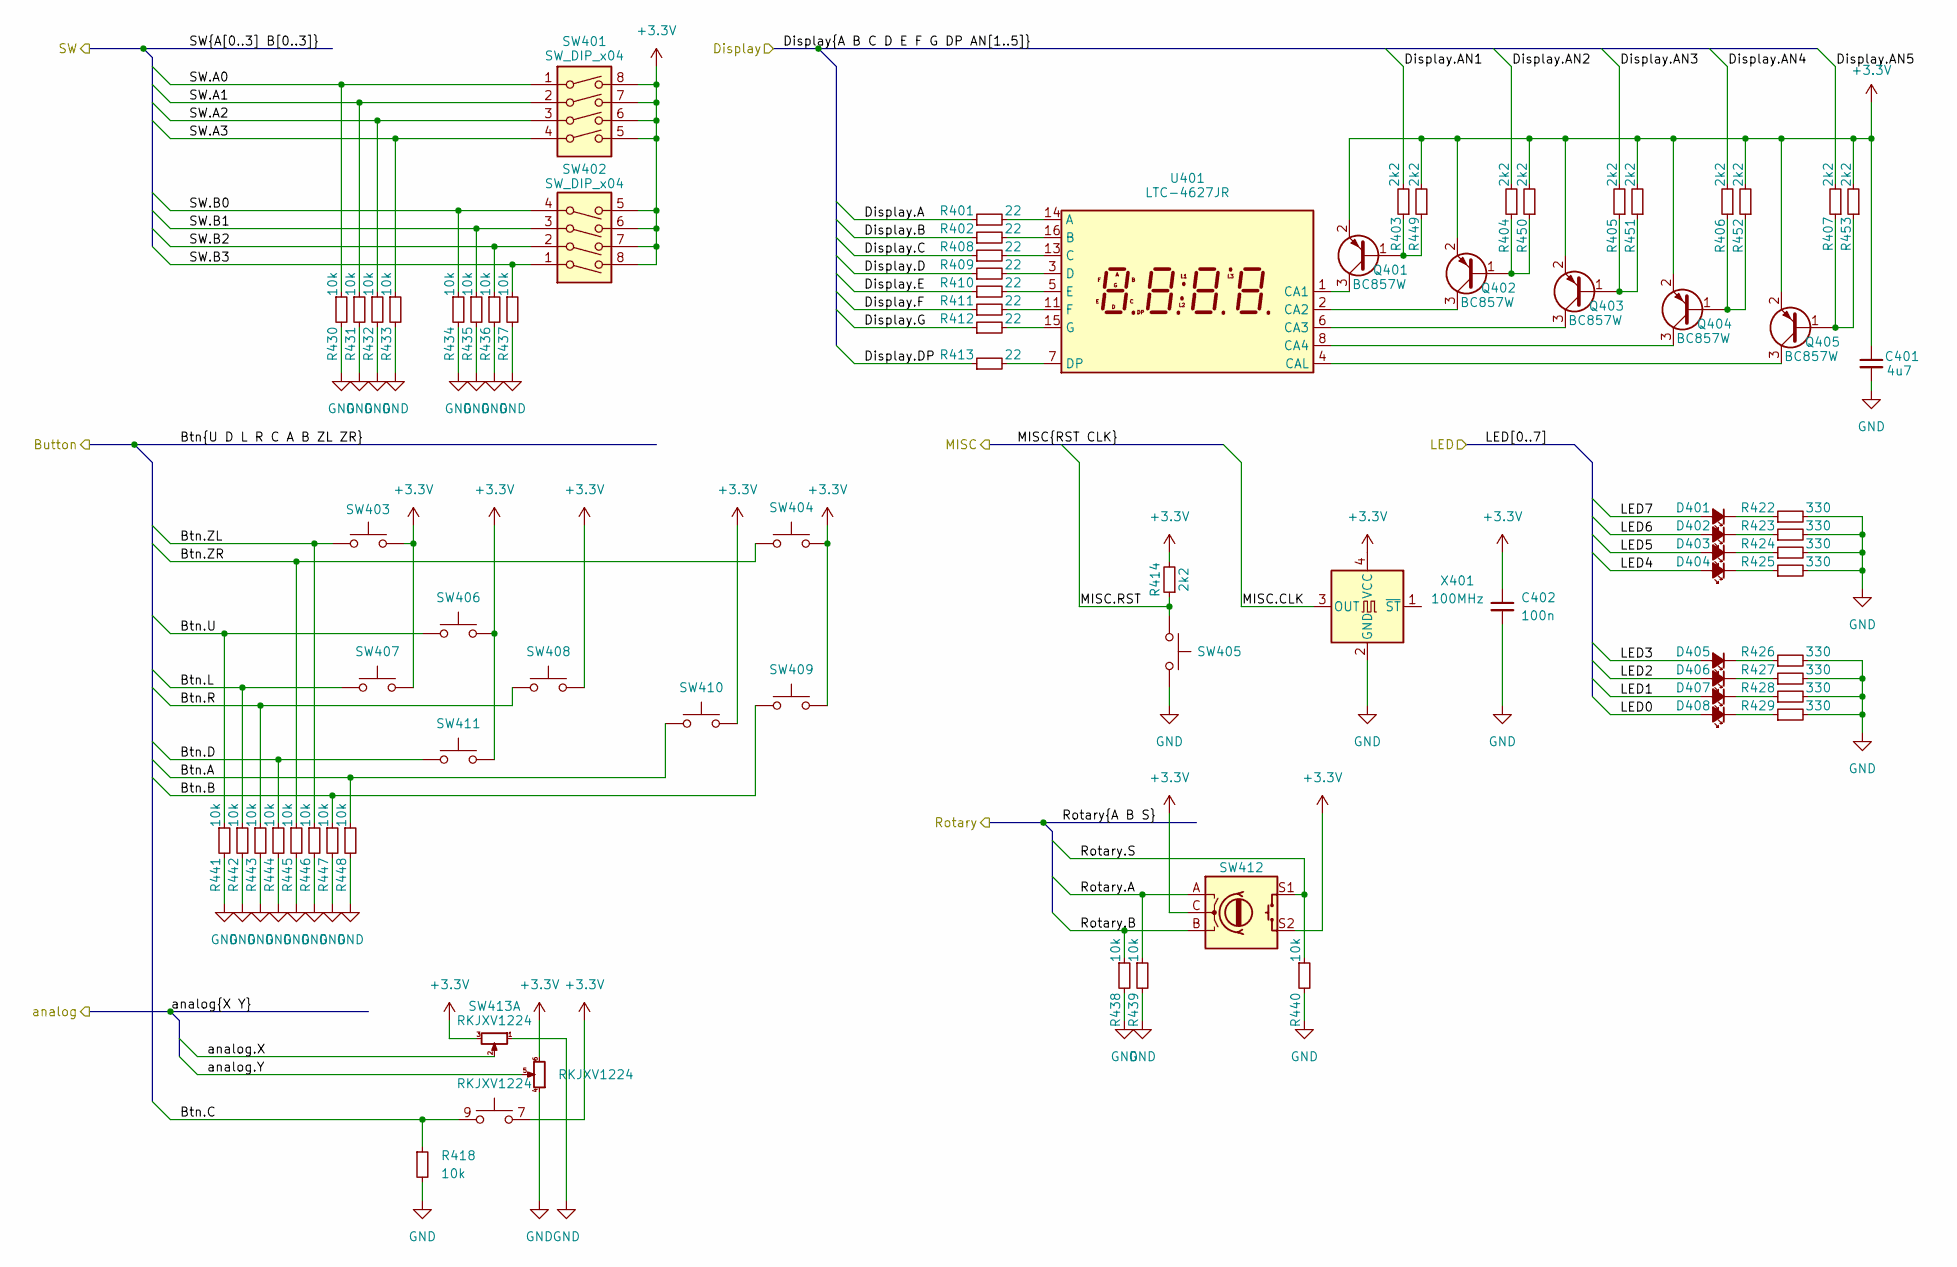
[picture p28: schematic io.kicad_sch]

Parts:
C401: 4u7; C_0603_1608Metric
C402: 100n; C_0402_1005Metric
D401, D402, D403, D404, D405, D406, D407, D408: LED_Small_Filled; LED_0603_1608Metric
Q401, Q402, Q403, Q404, Q405: BC857W; SOT-23-3
R401, R402, R408, R409, R410, R411, R412, R413: 22; R_0402_1005Metric
R403, R404, R405, R406, R407, R414, R449, R450, R451, R452, R453: 2k2; R_0402_1005Metric
R418, R430, R431, R432, R433, R434, R435, R436, R437, R438, R439, R440, R441, R442, R443, R444, R445, R446, R447, R448: 10k; R_0402_1005Metric
R422, R423, R424, R425, R426, R427, R428, R429: 330; R_0402_1005Metric
SW401, SW402: SW_DIP_x04; SW_DIP_SPSTx04_Slide_9.78x12.34mm_W7.62mm_P2.54mm
SW403, SW404: SW_Omron_B3FS; SW_Tactile_SPST_Angled_PTS645Vx39-2LFS
SW405, SW406, SW407, SW408, SW409, SW410, SW411: SW_Omron_B3FS; SW_PUSH_6mm_H4.3mm
SW412: RotaryEncoder_Switch; Alps_EC11E-Switch
SW413: RKJXV1224
U401: LTC-4627JR; LTC-4627Jx_compat
X401: 100MHz; Oscillator_SMD_Abracon_ASE-4Pin_3.2x2.5mm

Connections:
+3.3V: C401.1, C402.1, Q401.2 (E), Q402.2 (E), Q403.2 (E), Q404.2 (E), Q405.2 (E), R414.2, R449.2, R450.2, R451.2, R452.2, R453.2, SW401.5, SW401.6, SW401.7, SW401.8, SW402.5, SW402.6, SW402.7, SW402.8, SW403.2, SW404.1, SW406.2, SW407.2, SW408.2, SW409.2, SW410.2, SW411.2, SW412.C, SW412.S2, SW413.3, SW413.6, SW413.7 (A), SW413.8 (A), X401.4 (VCC); also elsewhere on the board
/ADC/analog.X: SW413.2; also elsewhere on the board
/ADC/analog.Y: SW413.5; also elsewhere on the board
/IO/Btn.A: R448.1, SW410.1; also elsewhere on the board
/IO/Btn.B: R447.1, SW409.1; also elsewhere on the board
/IO/Btn.C: R418.1, SW413.9 (B), SW413.10 (B); also elsewhere on the board
/IO/Btn.D: R444.1, SW411.1; also elsewhere on the board
/IO/Btn.L: R442.1, SW407.1; also elsewhere on the board
/IO/Btn.R: R443.1, SW408.1; also elsewhere on the board
/IO/Btn.U: R441.1, SW406.1; also elsewhere on the board
/IO/Btn.ZL: R446.1, SW403.1; also elsewhere on the board
/IO/Btn.ZR: R445.1, SW404.2; also elsewhere on the board
/IO/Display.A: R401.1; also elsewhere on the board
/IO/Display.AN1: R403.2; also elsewhere on the board
/IO/Display.AN2: R404.2; also elsewhere on the board
/IO/Display.AN3: R405.2; also elsewhere on the board
/IO/Display.AN4: R406.2; also elsewhere on the board
/IO/Display.AN5: R407.2; also elsewhere on the board
/IO/Display.B: R402.1; also elsewhere on the board
/IO/Display.C: R408.1; also elsewhere on the board
/IO/Display.D: R409.1; also elsewhere on the board
/IO/Display.DP: R413.1; also elsewhere on the board
/IO/Display.E: R410.1; also elsewhere on the board
/IO/Display.F: R411.1; also elsewhere on the board
/IO/Display.G: R412.1; also elsewhere on the board
/IO/LED0: D408.2 (A); also elsewhere on the board
/IO/LED1: D407.2 (A); also elsewhere on the board
/IO/LED2: D406.2 (A); also elsewhere on the board
/IO/LED3: D405.2 (A); also elsewhere on the board
/IO/LED4: D404.2 (A); also elsewhere on the board
/IO/LED5: D403.2 (A); also elsewhere on the board
/IO/LED6: D402.2 (A); also elsewhere on the board
/IO/LED7: D401.2 (A); also elsewhere on the board
/IO/MISC.CLK: X401.3 (OUT); also elsewhere on the board
/IO/MISC.RST: R414.1, SW405.1; also elsewhere on the board
/IO/Rotary.A: R439.1, SW412.A; also elsewhere on the board
/IO/Rotary.B: R438.1, SW412.B; also elsewhere on the board
/IO/Rotary.S: R440.1, SW412.S1; also elsewhere on the board
/IO/SW.A0: R430.1, SW401.1; also elsewhere on the board
/IO/SW.A1: R431.1, SW401.2; also elsewhere on the board
/IO/SW.A2: R432.1, SW401.3; also elsewhere on the board
/IO/SW.A3: R433.1, SW401.4; also elsewhere on the board
/IO/SW.B0: R434.1, SW402.4; also elsewhere on the board
/IO/SW.B1: R435.1, SW402.3; also elsewhere on the board
/IO/SW.B2: R436.1, SW402.2; also elsewhere on the board
/IO/SW.B3: R437.1, SW402.1; also elsewhere on the board
GND: C401.2, C402.2, R418.2, R422.2, R423.2, R424.2, R425.2, R426.2, R427.2, R428.2, R429.2, R430.2, R431.2, R432.2, R433.2, R434.2, R435.2, R436.2, R437.2, R438.2, R439.2, R440.2, R441.2, R442.2, R443.2, R444.2, R445.2, R446.2, R447.2, R448.2, SW405.2, SW413.1, SW413.4, X401.2 (GND); also elsewhere on the board
unnamed: D401.1 (K), R422.1
unnamed: D402.1 (K), R423.1
unnamed: D403.1 (K), R424.1
unnamed: D404.1 (K), R425.1
unnamed: D405.1 (K), R426.1
unnamed: D406.1 (K), R427.1
unnamed: D407.1 (K), R428.1
unnamed: D408.1 (K), R429.1
unnamed: Q401.1 (B), R403.1, R449.1
unnamed: Q401.3 (C), U401.1 (CA1)
unnamed: Q402.1 (B), R404.1, R450.1
unnamed: Q402.3 (C), U401.2 (CA2)
unnamed: Q403.1 (B), R405.1, R451.1
unnamed: Q403.3 (C), U401.6 (CA3)
unnamed: Q404.1 (B), R406.1, R452.1
unnamed: Q404.3 (C), U401.8 (CA4)
unnamed: Q405.1 (B), R407.1, R453.1
unnamed: Q405.3 (C), U401.4 (CAL)
unnamed: R401.2, U401.14 (A)
unnamed: R402.2, U401.16 (B)
unnamed: R408.2, U401.13 (C)
unnamed: R409.2, U401.3 (D)
unnamed: R413.2, U401.7 (DP)
unnamed: R410.2, U401.5 (E)
unnamed: R411.2, U401.11 (F)
unnamed: R412.2, U401.15 (G)

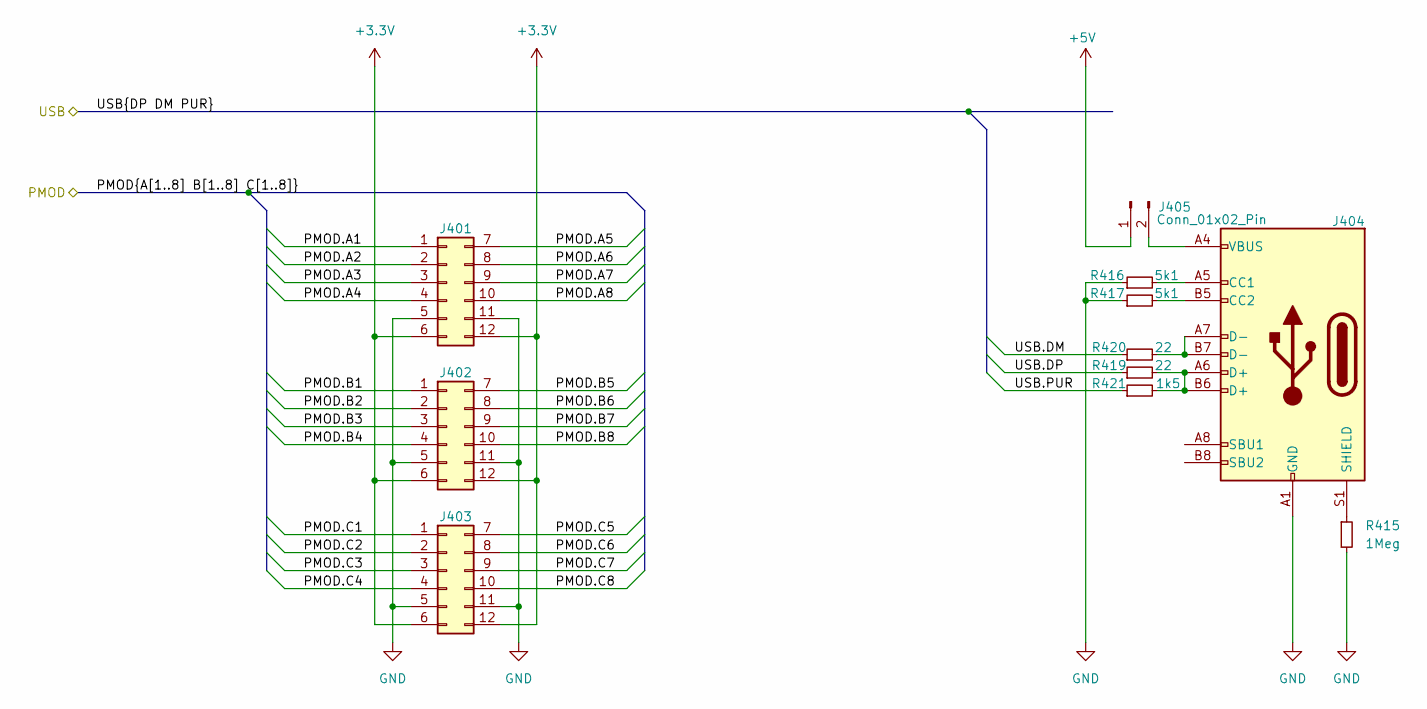
[picture p29: schematic conn.kicad_sch]

Parts:
J401, J402, J403: Conn_02x06_Top_Bottom; PMOD
J404: USB_C_Receptacle_USB2.0_16P; USB_C_Combo
J405: Conn_01x02_Pin; PinHeader_1x02_P2.54mm_Horizontal
R415: 1Meg; R_0402_1005Metric
R416, R417: 5k1; R_0402_1005Metric
R419, R420: 22; R_0402_1005Metric
R421: 1k5; R_0402_1005Metric

Connections:
+3.3V: J401.6, J401.12, J402.6, J402.12, J403.6, J403.12; also elsewhere on the board
+5V: J405.1; also elsewhere on the board
/Connectors/PMOD.A1: J401.1; also elsewhere on the board
/Connectors/PMOD.A2: J401.2; also elsewhere on the board
/Connectors/PMOD.A3: J401.3; also elsewhere on the board
/Connectors/PMOD.A4: J401.4; also elsewhere on the board
/Connectors/PMOD.A5: J401.7; also elsewhere on the board
/Connectors/PMOD.A6: J401.8; also elsewhere on the board
/Connectors/PMOD.A7: J401.9; also elsewhere on the board
/Connectors/PMOD.A8: J401.10; also elsewhere on the board
/Connectors/PMOD.B1: J402.1; also elsewhere on the board
/Connectors/PMOD.B2: J402.2; also elsewhere on the board
/Connectors/PMOD.B3: J402.3; also elsewhere on the board
/Connectors/PMOD.B4: J402.4; also elsewhere on the board
/Connectors/PMOD.B5: J402.7; also elsewhere on the board
/Connectors/PMOD.B6: J402.8; also elsewhere on the board
/Connectors/PMOD.B7: J402.9; also elsewhere on the board
/Connectors/PMOD.B8: J402.10; also elsewhere on the board
/Connectors/PMOD.C1: J403.1; also elsewhere on the board
/Connectors/PMOD.C2: J403.2; also elsewhere on the board
/Connectors/PMOD.C3: J403.3; also elsewhere on the board
/Connectors/PMOD.C4: J403.4; also elsewhere on the board
/Connectors/PMOD.C5: J403.7; also elsewhere on the board
/Connectors/PMOD.C6: J403.8; also elsewhere on the board
/Connectors/PMOD.C7: J403.9; also elsewhere on the board
/Connectors/PMOD.C8: J403.10; also elsewhere on the board
/Connectors/USB.DM: R420.1; also elsewhere on the board
/Connectors/USB.DP: R419.1; also elsewhere on the board
/Connectors/USB.PUR: R421.1; also elsewhere on the board
GND: J401.5, J401.11, J402.5, J402.11, J403.5, J403.11, J404.A1 (GND), J404.A12 (GND), J404.B1 (GND), J404.B12 (GND), R415.2, R416.1, R417.1; also elsewhere on the board
unnamed: J404.A5 (CC1), R416.2
unnamed: J404.B5 (CC2), R417.2
unnamed: J404.A6 (D+), J404.B6 (D+), R419.2, R421.2
unnamed: J404.A7 (D-), J404.B7 (D-), R420.2
unnamed: J404.S1 (SHIELD), R415.1
unnamed: J404.A4 (VBUS), J404.A9 (VBUS), J404.B4 (VBUS), J404.B9 (VBUS), J405.2

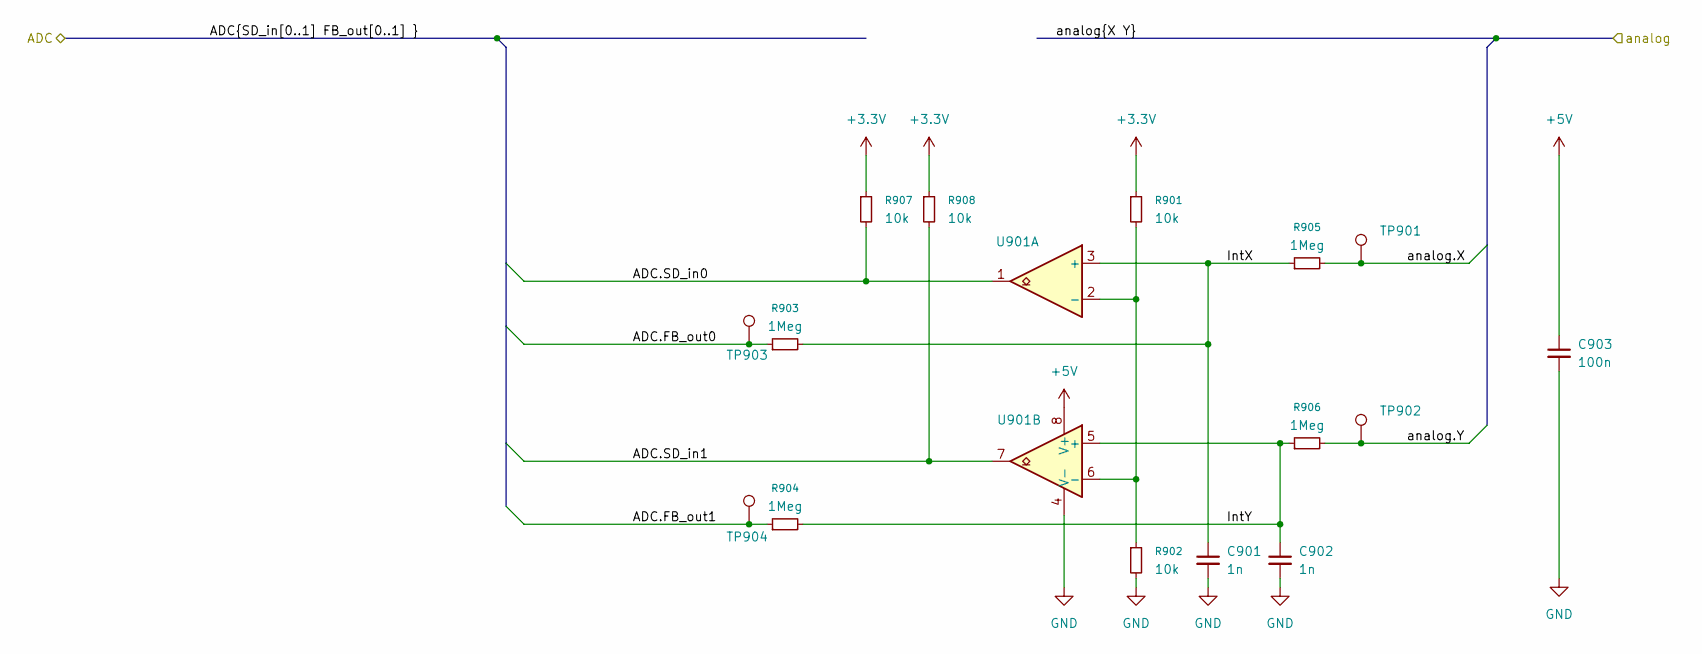
[picture p30: schematic adc.kicad_sch]

Parts:
C901, C902: 1n; C_0402_1005Metric
C903: 100n; C_0402_1005Metric
R901, R902, R907, R908: 10k; R_0402_1005Metric
R903, R904, R905, R906: 1Meg; R_0402_1005Metric
TP901, TP902, TP903, TP904: TestPoint; TestPoint_THTPad_D2.0mm_Drill1.0mm
U901: LM2903; VSSOP-8_3x3mm_P0.65mm

Connections:
+3.3V: R901.1, R907.1, R908.1; also elsewhere on the board
+5V: C903.1, U901.8 (V+); also elsewhere on the board
/ADC/ADC.FB_out0: R903.1, TP903.1 (1_1); also elsewhere on the board
/ADC/ADC.FB_out1: R904.1, TP904.1 (1_1); also elsewhere on the board
/ADC/ADC.SD_in0: R907.2, U901.1; also elsewhere on the board
/ADC/ADC.SD_in1: R908.2, U901.7; also elsewhere on the board
/ADC/IntX: C901.1, R903.2, R905.1, U901.3 (+)
/ADC/IntY: C902.1, R904.2, R906.1, U901.5 (+)
/ADC/analog.X: R905.2, TP901.1 (1_1); also elsewhere on the board
/ADC/analog.Y: R906.2, TP902.1 (1_1); also elsewhere on the board
GND: C901.2, C902.2, C903.2, R902.2, U901.4 (V-); also elsewhere on the board
unnamed: R901.2, R902.1, U901.2 (-), U901.6 (-)

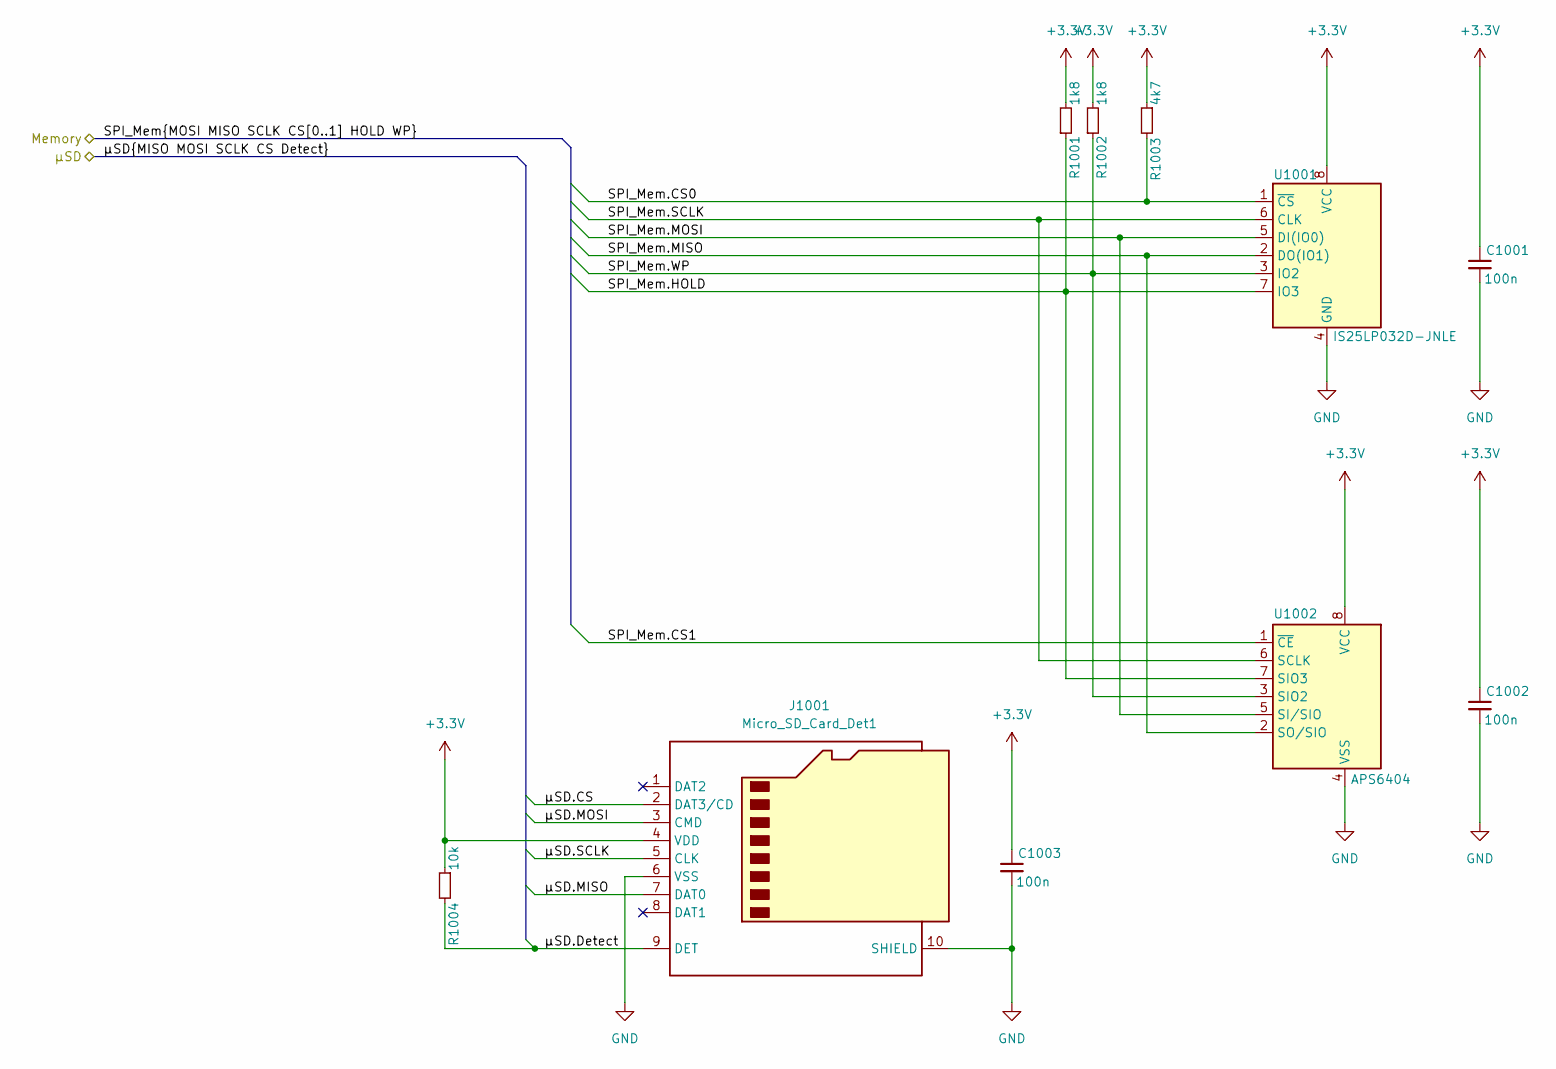
[picture p31: schematic memory.kicad_sch]

Parts:
C1001, C1002, C1003: 100n; C_0402_1005Metric
J1001: Micro_SD_Card_Det1; microSD_Wuerth_693071010811
R1001, R1002: 1k8; R_0402_1005Metric
R1003: 4k7; R_0402_1005Metric
R1004: 10k; R_0402_1005Metric
U1001: IS25LP032D-JNLE; SOIC-8_4_5.3_combo_P1.27mm
U1002: APS6404; SOIC-8_3.9x4.9mm_P1.27mm

Connections:
+3.3V: C1001.1, C1002.1, C1003.1, J1001.4 (VDD), R1001.2, R1002.2, R1003.1, R1004.1, U1001.8 (VCC), U1002.8 (VCC); also elsewhere on the board
/Memory/SPI_Mem.CS0: R1003.2, U1001.1 (~CS); also elsewhere on the board
/Memory/SPI_Mem.CS1: U1002.1 (~CE); also elsewhere on the board
/Memory/SPI_Mem.HOLD: R1001.1, U1001.7 (IO3), U1002.7 (SIO3); also elsewhere on the board
/Memory/SPI_Mem.MISO: U1001.2 (DO(IO1)), U1002.2 (SO/SIO); also elsewhere on the board
/Memory/SPI_Mem.MOSI: U1001.5 (DI(IO0)), U1002.5 (SI/SIO); also elsewhere on the board
/Memory/SPI_Mem.SCLK: U1001.6 (CLK), U1002.6 (SCLK); also elsewhere on the board
/Memory/SPI_Mem.WP: R1002.1, U1001.3 (IO2), U1002.3 (SIO2); also elsewhere on the board
/Memory/μSD.CS: J1001.2 (DAT3/CD); also elsewhere on the board
/Memory/μSD.Detect: J1001.9 (DET), R1004.2; also elsewhere on the board
/Memory/μSD.MISO: J1001.7 (DAT0); also elsewhere on the board
/Memory/μSD.MOSI: J1001.3 (CMD); also elsewhere on the board
/Memory/μSD.SCLK: J1001.5 (CLK); also elsewhere on the board
GND: C1001.2, C1002.2, C1003.2, J1001.6 (VSS), J1001.10 (SHIELD), U1001.4 (GND), U1002.4 (VSS); also elsewhere on the board

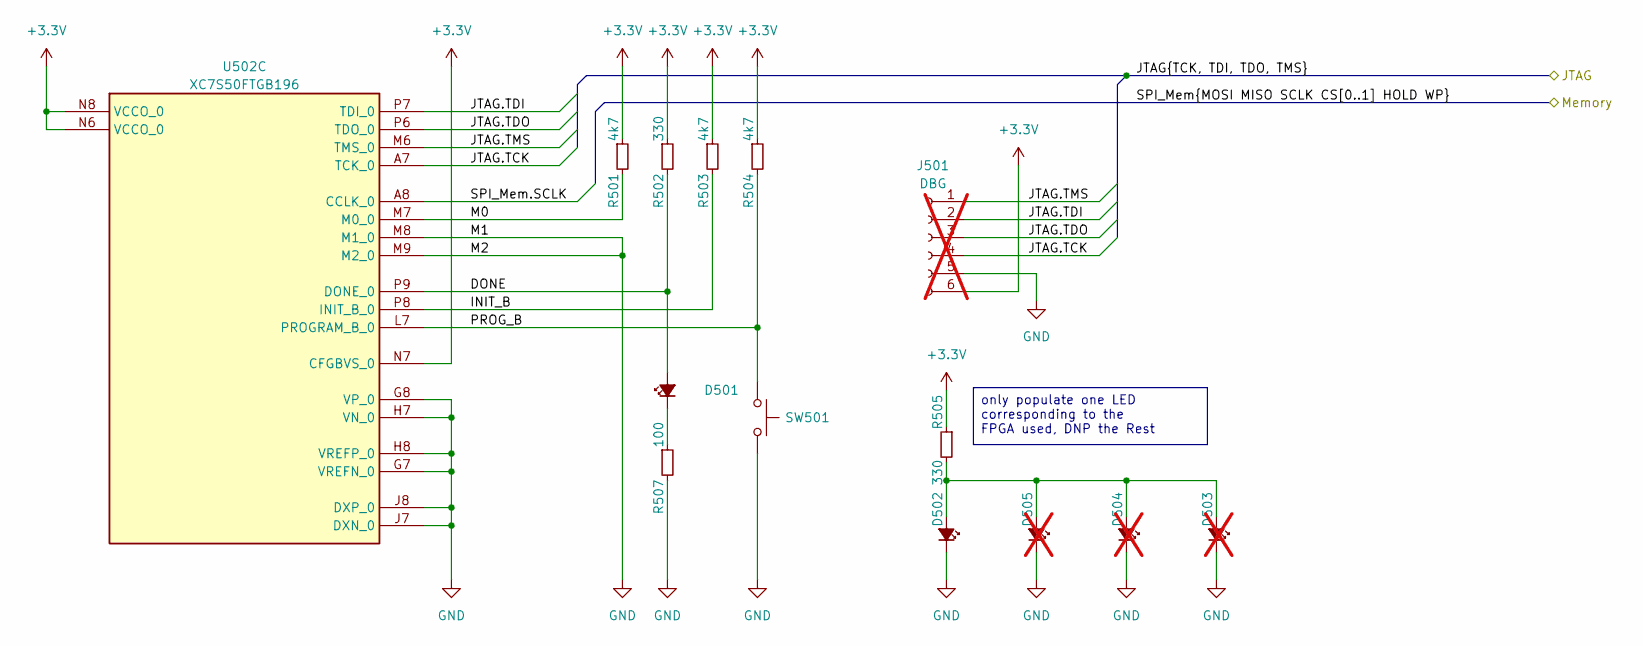
[picture p32: schematic FPGA_Config.kicad_sch]

Parts:
D501: LED_Small_Filled; LED_0603_1608Metric
D502: LED_Small_Filled; LED_0603_1608Metric_Box
D503, D504, D505: LED_Small_Filled; LED_0603_1608Metric_Box; not fitted
J501: DBG; PinHeader_1x06_P2.54mm_Vertical_versetzt; not fitted
R501, R503, R504: 4k7; R_0402_1005Metric
R502, R505: 330; R_0402_1005Metric
R507: 100; R_0402_1005Metric
SW501: SW_Omron_B3FS; SW_PUSH_6mm_H4.3mm
U502: XC7S50FTGB196; Xilinx_FTGB196

Connections:
+3.3V: J501.6, R501.1, R502.1, R503.1, R504.1, R505.1, U502.N6 (VCCO_0), U502.N7 (CFGBVS_0), U502.N8 (VCCO_0); also elsewhere on the board
/FPGA/FPGA_Config/DONE: D501.2 (A), R502.2, U502.P9 (DONE_0)
/FPGA/FPGA_Config/INIT_B: R503.2, U502.P8 (INIT_B_0)
/FPGA/FPGA_Config/M0: R501.2, U502.M7 (M0_0)
/FPGA/FPGA_Config/PROG_B: R504.2, SW501.1, U502.L7 (PROGRAM_B_0)
/FT2232/JTAG.TCK: J501.4, U502.A7 (TCK_0); also elsewhere on the board
/FT2232/JTAG.TDI: J501.2, U502.P7 (TDI_0); also elsewhere on the board
/FT2232/JTAG.TDO: J501.3, U502.P6 (TDO_0); also elsewhere on the board
/FT2232/JTAG.TMS: J501.1, U502.M6 (TMS_0); also elsewhere on the board
/Memory/SPI_Mem.SCLK: U502.A8 (CCLK_0); also elsewhere on the board
GND: D502.1 (K), D503.1 (K), D504.1 (K), D505.1 (K), J501.5, R507.2, SW501.2, U502.G7 (VREFN_0), U502.G8 (VP_0), U502.H7 (VN_0), U502.H8 (VREFP_0), U502.J7 (DXN_0), U502.J8 (DXP_0), U502.M8 (M1_0), U502.M9 (M2_0); also elsewhere on the board
unnamed: D501.1 (K), R507.1
unnamed: D502.2 (A), D503.2 (A), D504.2 (A), D505.2 (A), R505.2

Notes on the sheet:
only populate one LED corresponding to the FPGA used, DNP the Rest
