AWenzel83/FPGA-Dev/KiCad/FPGA-Devel.kicad_pcb

## KiCad design KiCad/FPGA-Devel.kicad_pcb (continued)

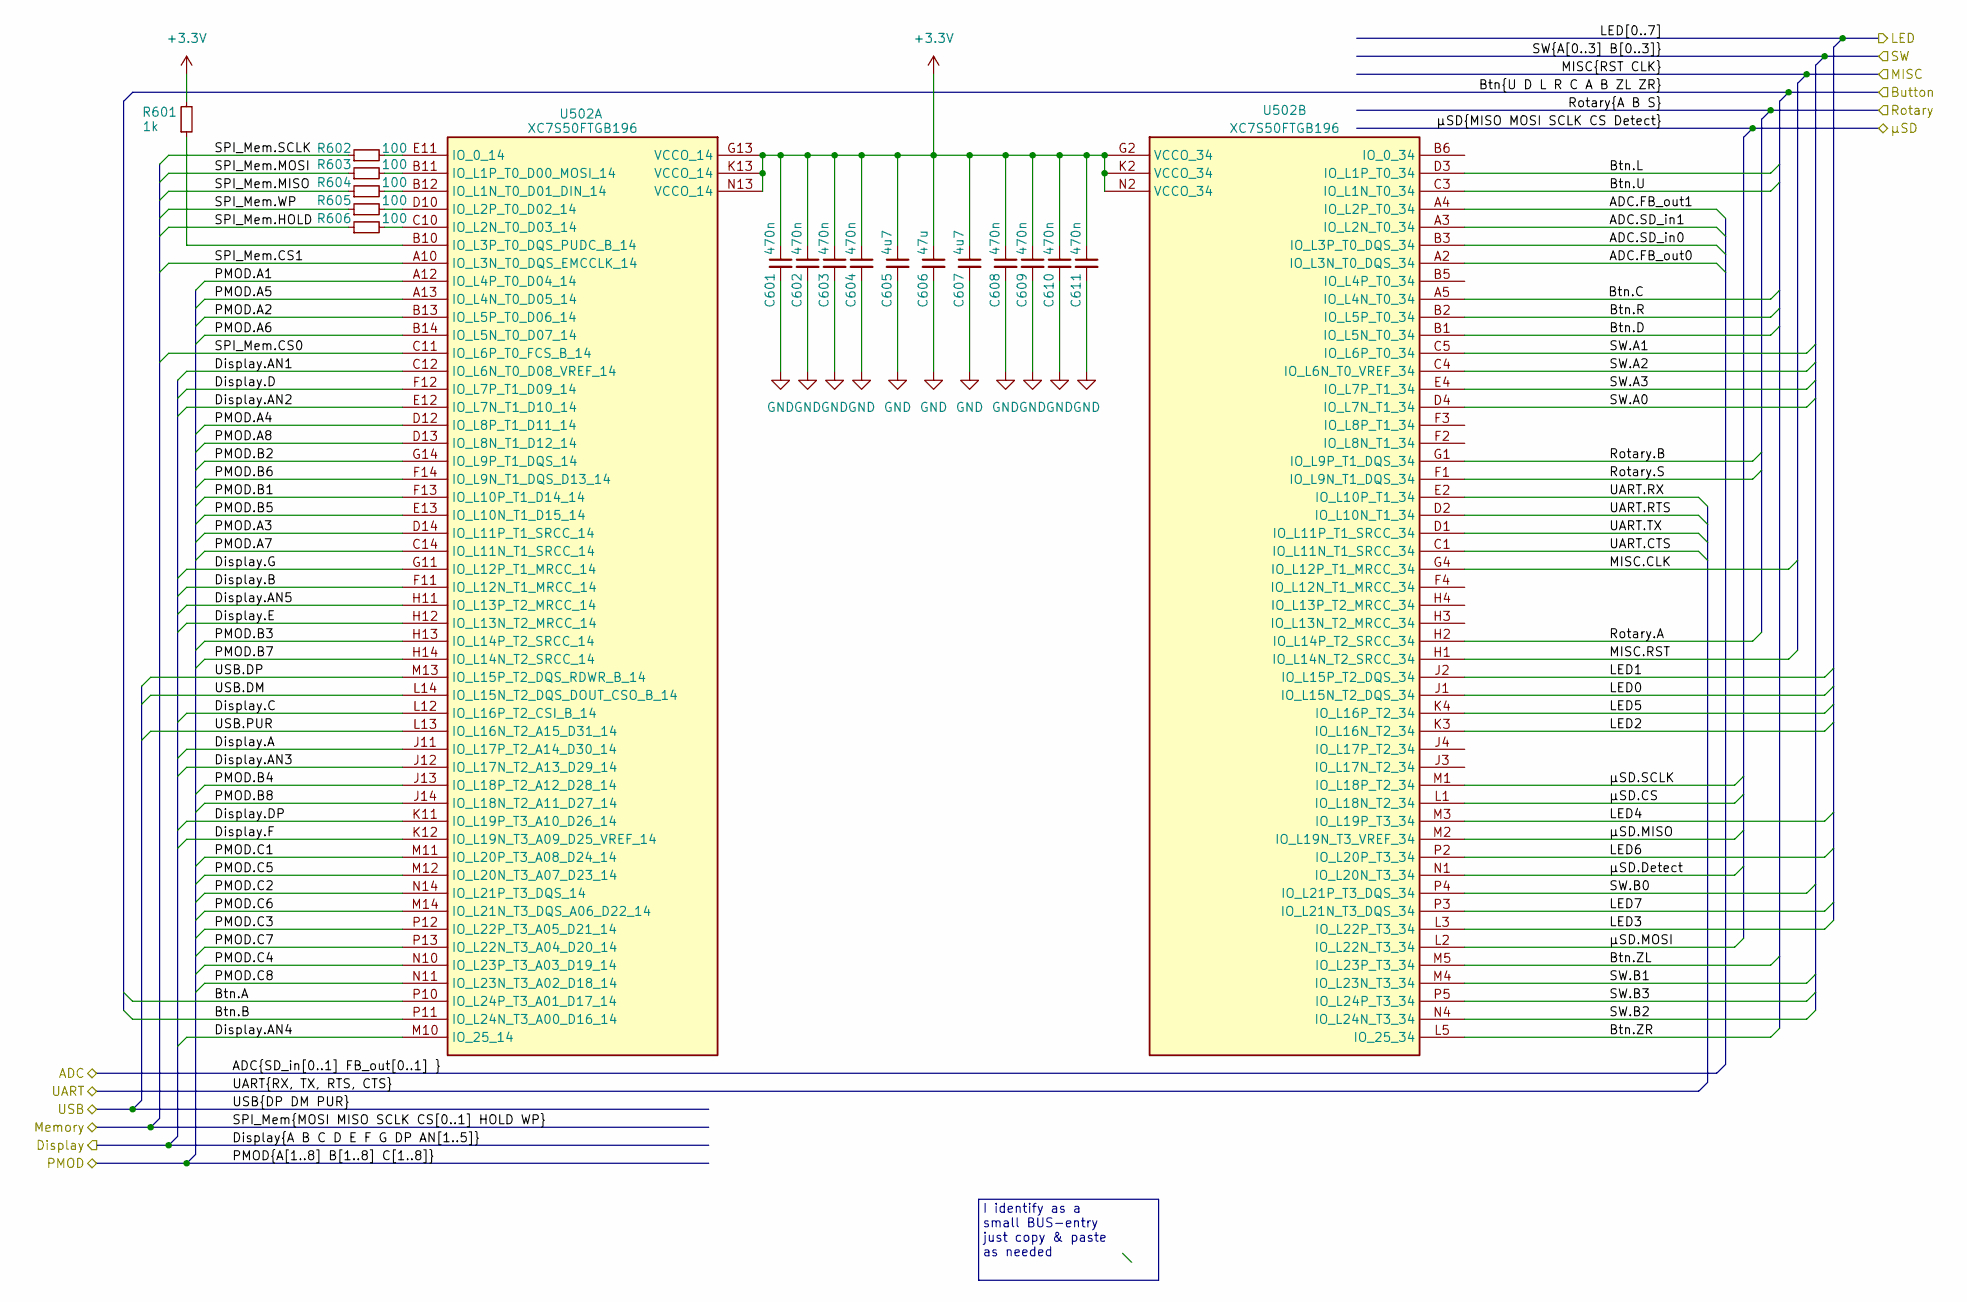
[picture p33: schematic FPGA_IO.kicad_sch]

Parts:
C601, C602, C603, C604, C608, C609, C610, C611: 470n; C_0402_1005Metric
C605, C607: 4u7; C_0603_1608Metric
C606: 47u; C_1206_3216Metric
R601: 1k; R_0402_1005Metric
R602, R603, R604, R605, R606: 100; R_0402_1005Metric
U502: XC7S50FTGB196; Xilinx_FTGB196

Connections:
+3.3V: C601.1, C602.1, C603.1, C604.1, C605.1, C606.1, C607.1, C608.1, C609.1, C610.1, C611.1, R601.2, U502.G2 (VCCO_34), U502.G13 (VCCO_14), U502.K2 (VCCO_34), U502.K13 (VCCO_14), U502.N2 (VCCO_34), U502.N13 (VCCO_14); also elsewhere on the board
/ADC/ADC.FB_out0: U502.A2 (IO_L3N_T0_DQS_34); also elsewhere on the board
/ADC/ADC.FB_out1: U502.A4 (IO_L2P_T0_34); also elsewhere on the board
/ADC/ADC.SD_in0: U502.B3 (IO_L3P_T0_DQS_34); also elsewhere on the board
/ADC/ADC.SD_in1: U502.A3 (IO_L2N_T0_34); also elsewhere on the board
/Connectors/PMOD.A1: U502.A12 (IO_L4P_T0_D04_14); also elsewhere on the board
/Connectors/PMOD.A2: U502.B13 (IO_L5P_T0_D06_14); also elsewhere on the board
/Connectors/PMOD.A3: U502.D14 (IO_L11P_T1_SRCC_14); also elsewhere on the board
/Connectors/PMOD.A4: U502.D12 (IO_L8P_T1_D11_14); also elsewhere on the board
/Connectors/PMOD.A5: U502.A13 (IO_L4N_T0_D05_14); also elsewhere on the board
/Connectors/PMOD.A6: U502.B14 (IO_L5N_T0_D07_14); also elsewhere on the board
/Connectors/PMOD.A7: U502.C14 (IO_L11N_T1_SRCC_14); also elsewhere on the board
/Connectors/PMOD.A8: U502.D13 (IO_L8N_T1_D12_14); also elsewhere on the board
/Connectors/PMOD.B1: U502.F13 (IO_L10P_T1_D14_14); also elsewhere on the board
/Connectors/PMOD.B2: U502.G14 (IO_L9P_T1_DQS_14); also elsewhere on the board
/Connectors/PMOD.B3: U502.H13 (IO_L14P_T2_SRCC_14); also elsewhere on the board
/Connectors/PMOD.B4: U502.J13 (IO_L18P_T2_A12_D28_14); also elsewhere on the board
/Connectors/PMOD.B5: U502.E13 (IO_L10N_T1_D15_14); also elsewhere on the board
/Connectors/PMOD.B6: U502.F14 (IO_L9N_T1_DQS_D13_14); also elsewhere on the board
/Connectors/PMOD.B7: U502.H14 (IO_L14N_T2_SRCC_14); also elsewhere on the board
/Connectors/PMOD.B8: U502.J14 (IO_L18N_T2_A11_D27_14); also elsewhere on the board
/Connectors/PMOD.C1: U502.M11 (IO_L20P_T3_A08_D24_14); also elsewhere on the board
/Connectors/PMOD.C2: U502.N14 (IO_L21P_T3_DQS_14); also elsewhere on the board
/Connectors/PMOD.C3: U502.P12 (IO_L22P_T3_A05_D21_14); also elsewhere on the board
/Connectors/PMOD.C4: U502.N10 (IO_L23P_T3_A03_D19_14); also elsewhere on the board
/Connectors/PMOD.C5: U502.M12 (IO_L20N_T3_A07_D23_14); also elsewhere on the board
/Connectors/PMOD.C6: U502.M14 (IO_L21N_T3_DQS_A06_D22_14); also elsewhere on the board
/Connectors/PMOD.C7: U502.P13 (IO_L22N_T3_A04_D20_14); also elsewhere on the board
/Connectors/PMOD.C8: U502.N11 (IO_L23N_T3_A02_D18_14); also elsewhere on the board
/Connectors/USB.DM: U502.L14 (IO_L15N_T2_DQS_DOUT_CSO_B_14); also elsewhere on the board
/Connectors/USB.DP: U502.M13 (IO_L15P_T2_DQS_RDWR_B_14); also elsewhere on the board
/Connectors/USB.PUR: U502.L13 (IO_L16N_T2_A15_D31_14); also elsewhere on the board
/FT2232/UART.CTS: U502.C1 (IO_L11N_T1_SRCC_34); also elsewhere on the board
/FT2232/UART.RTS: U502.D2 (IO_L10N_T1_34); also elsewhere on the board
/FT2232/UART.RX: U502.E2 (IO_L10P_T1_34); also elsewhere on the board
/FT2232/UART.TX: U502.D1 (IO_L11P_T1_SRCC_34); also elsewhere on the board
/IO/Btn.A: U502.P10 (IO_L24P_T3_A01_D17_14); also elsewhere on the board
/IO/Btn.B: U502.P11 (IO_L24N_T3_A00_D16_14); also elsewhere on the board
/IO/Btn.C: U502.A5 (IO_L4N_T0_34); also elsewhere on the board
/IO/Btn.D: U502.B1 (IO_L5N_T0_34); also elsewhere on the board
/IO/Btn.L: U502.D3 (IO_L1P_T0_34); also elsewhere on the board
/IO/Btn.R: U502.B2 (IO_L5P_T0_34); also elsewhere on the board
/IO/Btn.U: U502.C3 (IO_L1N_T0_34); also elsewhere on the board
/IO/Btn.ZL: U502.M5 (IO_L23P_T3_34); also elsewhere on the board
/IO/Btn.ZR: U502.L5 (IO_25_34); also elsewhere on the board
/IO/Display.A: U502.J11 (IO_L17P_T2_A14_D30_14); also elsewhere on the board
/IO/Display.AN1: U502.C12 (IO_L6N_T0_D08_VREF_14); also elsewhere on the board
/IO/Display.AN2: U502.E12 (IO_L7N_T1_D10_14); also elsewhere on the board
/IO/Display.AN3: U502.J12 (IO_L17N_T2_A13_D29_14); also elsewhere on the board
/IO/Display.AN4: U502.M10 (IO_25_14); also elsewhere on the board
/IO/Display.AN5: U502.H11 (IO_L13P_T2_MRCC_14); also elsewhere on the board
/IO/Display.B: U502.F11 (IO_L12N_T1_MRCC_14); also elsewhere on the board
/IO/Display.C: U502.L12 (IO_L16P_T2_CSI_B_14); also elsewhere on the board
/IO/Display.D: U502.F12 (IO_L7P_T1_D09_14); also elsewhere on the board
/IO/Display.DP: U502.K11 (IO_L19P_T3_A10_D26_14); also elsewhere on the board
/IO/Display.E: U502.H12 (IO_L13N_T2_MRCC_14); also elsewhere on the board
/IO/Display.F: U502.K12 (IO_L19N_T3_A09_D25_VREF_14); also elsewhere on the board
/IO/Display.G: U502.G11 (IO_L12P_T1_MRCC_14); also elsewhere on the board
/IO/LED0: U502.J1 (IO_L15N_T2_DQS_34); also elsewhere on the board
/IO/LED1: U502.J2 (IO_L15P_T2_DQS_34); also elsewhere on the board
/IO/LED2: U502.K3 (IO_L16N_T2_34); also elsewhere on the board
/IO/LED3: U502.L3 (IO_L22P_T3_34); also elsewhere on the board
/IO/LED4: U502.M3 (IO_L19P_T3_34); also elsewhere on the board
/IO/LED5: U502.K4 (IO_L16P_T2_34); also elsewhere on the board
/IO/LED6: U502.P2 (IO_L20P_T3_34); also elsewhere on the board
/IO/LED7: U502.P3 (IO_L21N_T3_DQS_34); also elsewhere on the board
/IO/MISC.CLK: U502.G4 (IO_L12P_T1_MRCC_34); also elsewhere on the board
/IO/MISC.RST: U502.H1 (IO_L14N_T2_SRCC_34); also elsewhere on the board
/IO/Rotary.A: U502.H2 (IO_L14P_T2_SRCC_34); also elsewhere on the board
/IO/Rotary.B: U502.G1 (IO_L9P_T1_DQS_34); also elsewhere on the board
/IO/Rotary.S: U502.F1 (IO_L9N_T1_DQS_34); also elsewhere on the board
/IO/SW.A0: U502.D4 (IO_L7N_T1_34); also elsewhere on the board
/IO/SW.A1: U502.C5 (IO_L6P_T0_34); also elsewhere on the board
/IO/SW.A2: U502.C4 (IO_L6N_T0_VREF_34); also elsewhere on the board
/IO/SW.A3: U502.E4 (IO_L7P_T1_34); also elsewhere on the board
/IO/SW.B0: U502.P4 (IO_L21P_T3_DQS_34); also elsewhere on the board
/IO/SW.B1: U502.M4 (IO_L23N_T3_34); also elsewhere on the board
/IO/SW.B2: U502.N4 (IO_L24N_T3_34); also elsewhere on the board
/IO/SW.B3: U502.P5 (IO_L24P_T3_34); also elsewhere on the board
/Memory/SPI_Mem.CS0: U502.C11 (IO_L6P_T0_FCS_B_14); also elsewhere on the board
/Memory/SPI_Mem.CS1: U502.A10 (IO_L3N_T0_DQS_EMCCLK_14); also elsewhere on the board
/Memory/SPI_Mem.HOLD: R606.1; also elsewhere on the board
/Memory/SPI_Mem.MISO: R604.1; also elsewhere on the board
/Memory/SPI_Mem.MOSI: R603.1; also elsewhere on the board
/Memory/SPI_Mem.SCLK: R602.1; also elsewhere on the board
/Memory/SPI_Mem.WP: R605.1; also elsewhere on the board
/Memory/μSD.CS: U502.L1 (IO_L18N_T2_34); also elsewhere on the board
/Memory/μSD.Detect: U502.N1 (IO_L20N_T3_34); also elsewhere on the board
/Memory/μSD.MISO: U502.M2 (IO_L19N_T3_VREF_34); also elsewhere on the board
/Memory/μSD.MOSI: U502.L2 (IO_L22N_T3_34); also elsewhere on the board
/Memory/μSD.SCLK: U502.M1 (IO_L18P_T2_34); also elsewhere on the board
GND: C601.2, C602.2, C603.2, C604.2, C605.2, C606.2, C607.2, C608.2, C609.2, C610.2, C611.2; also elsewhere on the board
unnamed: R602.2, U502.E11 (IO_0_14)
unnamed: R604.2, U502.B12 (IO_L1N_T0_D01_DIN_14)
unnamed: R603.2, U502.B11 (IO_L1P_T0_D00_MOSI_14)
unnamed: R606.2, U502.C10 (IO_L2N_T0_D03_14)
unnamed: R605.2, U502.D10 (IO_L2P_T0_D02_14)
unnamed: R601.1, U502.B10 (IO_L3P_T0_DQS_PUDC_B_14)

Notes on the sheet:
I identify as a small BUS-entry just copy & paste as needed

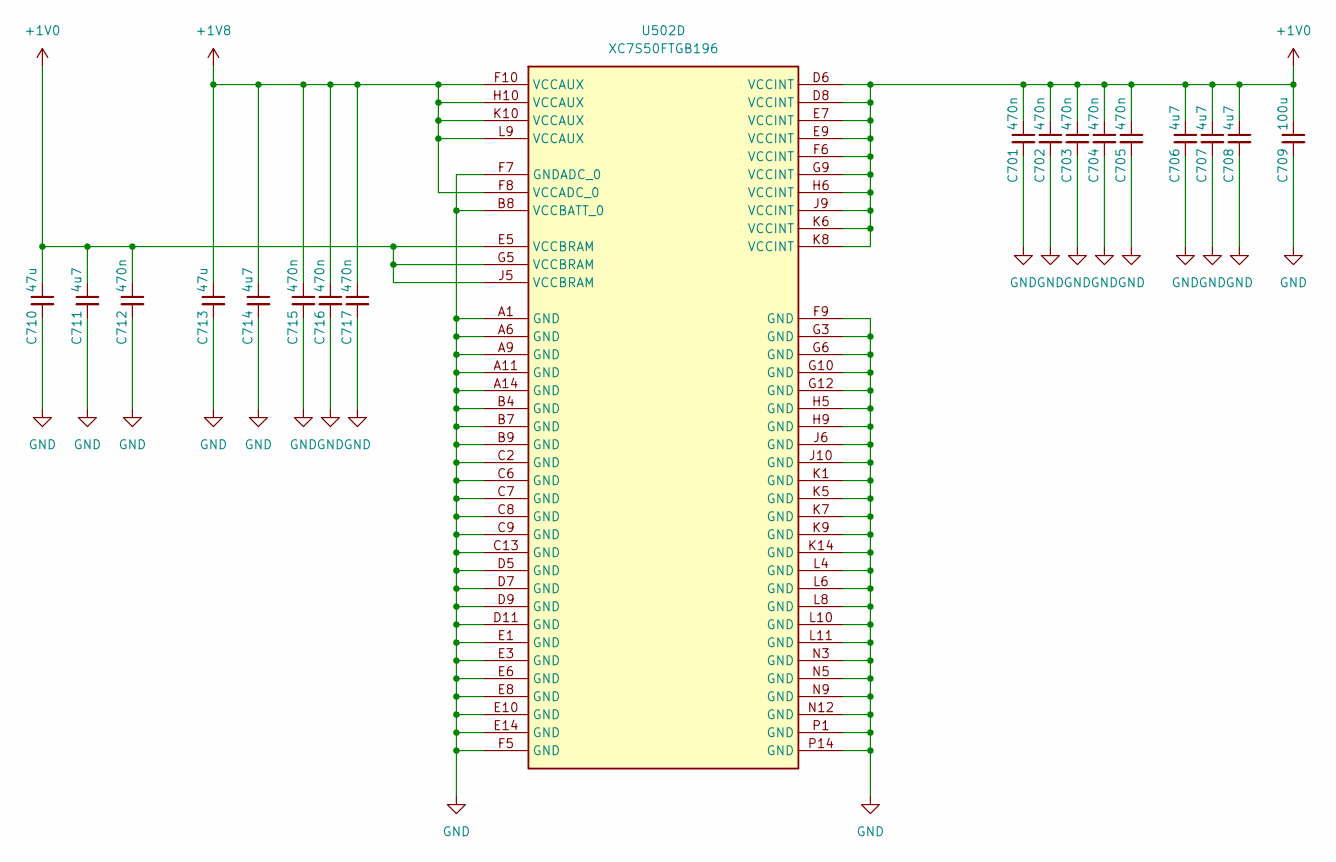
[picture p34: schematic FPGA_Power.kicad_sch]

Parts:
C701, C702, C703, C704, C705, C712, C715, C716, C717: 470n; C_0402_1005Metric
C706, C707, C708, C711, C714: 4u7; C_0603_1608Metric
C709: 100u; C_1206_3216Metric
C710, C713: 47u; C_1206_3216Metric
U502: XC7S50FTGB196; Xilinx_FTGB196

Connections:
+1V0: C701.1, C702.1, C703.1, C704.1, C705.1, C706.1, C707.1, C708.1, C709.1, C710.1, C711.1, C712.1, U502.D6 (VCCINT), U502.D8 (VCCINT), U502.E5 (VCCBRAM), U502.E7 (VCCINT), U502.E9 (VCCINT), U502.F6 (VCCINT), U502.G5 (VCCBRAM), U502.G9 (VCCINT), U502.H6 (VCCINT), U502.J5 (VCCBRAM), U502.J9 (VCCINT), U502.K6 (VCCINT), U502.K8 (VCCINT); also elsewhere on the board
+1V8: C713.1, C714.1, C715.1, C716.1, C717.1, U502.F8 (VCCADC_0), U502.F10 (VCCAUX), U502.H10 (VCCAUX), U502.K10 (VCCAUX), U502.L9 (VCCAUX); also elsewhere on the board
GND: C701.2, C702.2, C703.2, C704.2, C705.2, C706.2, C707.2, C708.2, C709.2, C710.2, C711.2, C712.2, C713.2, C714.2, C715.2, C716.2, C717.2, U502.A1 (GND), U502.A6 (GND), U502.A9 (GND), U502.A11 (GND), U502.A14 (GND), U502.B4 (GND), U502.B7 (GND), U502.B8 (VCCBATT_0), U502.B9 (GND), U502.C2 (GND), U502.C6 (GND), U502.C7 (GND), U502.C8 (GND), U502.C9 (GND), U502.C13 (GND), U502.D5 (GND), U502.D7 (GND), U502.D9 (GND), U502.D11 (GND), U502.E1 (GND), U502.E3 (GND), U502.E6 (GND), U502.E8 (GND), U502.E10 (GND), U502.E14 (GND), U502.F5 (GND), U502.F7 (GNDADC_0), U502.F9 (GND), U502.G3 (GND), U502.G6 (GND), U502.G10 (GND), U502.G12 (GND), U502.H5 (GND), U502.H9 (GND), U502.J6 (GND), U502.J10 (GND), U502.K1 (GND), U502.K5 (GND), U502.K7 (GND), U502.K9 (GND), U502.K14 (GND), U502.L4 (GND), U502.L6 (GND), U502.L8 (GND), U502.L10 (GND), U502.L11 (GND), U502.N3 (GND), U502.N5 (GND), U502.N9 (GND), U502.N12 (GND), U502.P1 (GND), U502.P14 (GND); also elsewhere on the board

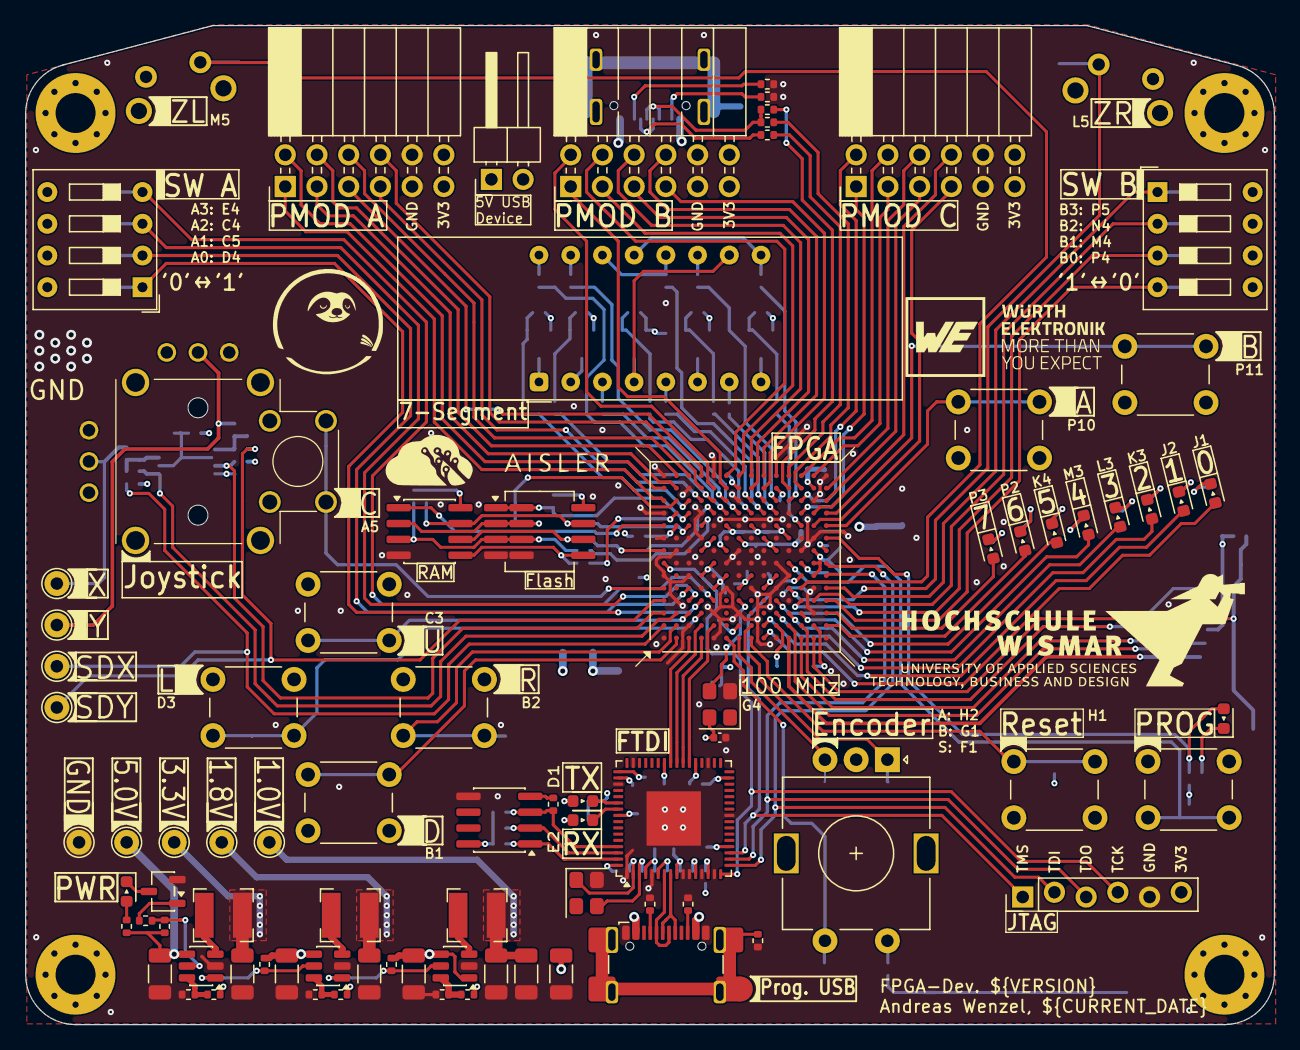
[picture p35: board FPGA-Devel.kicad_pcb from above]

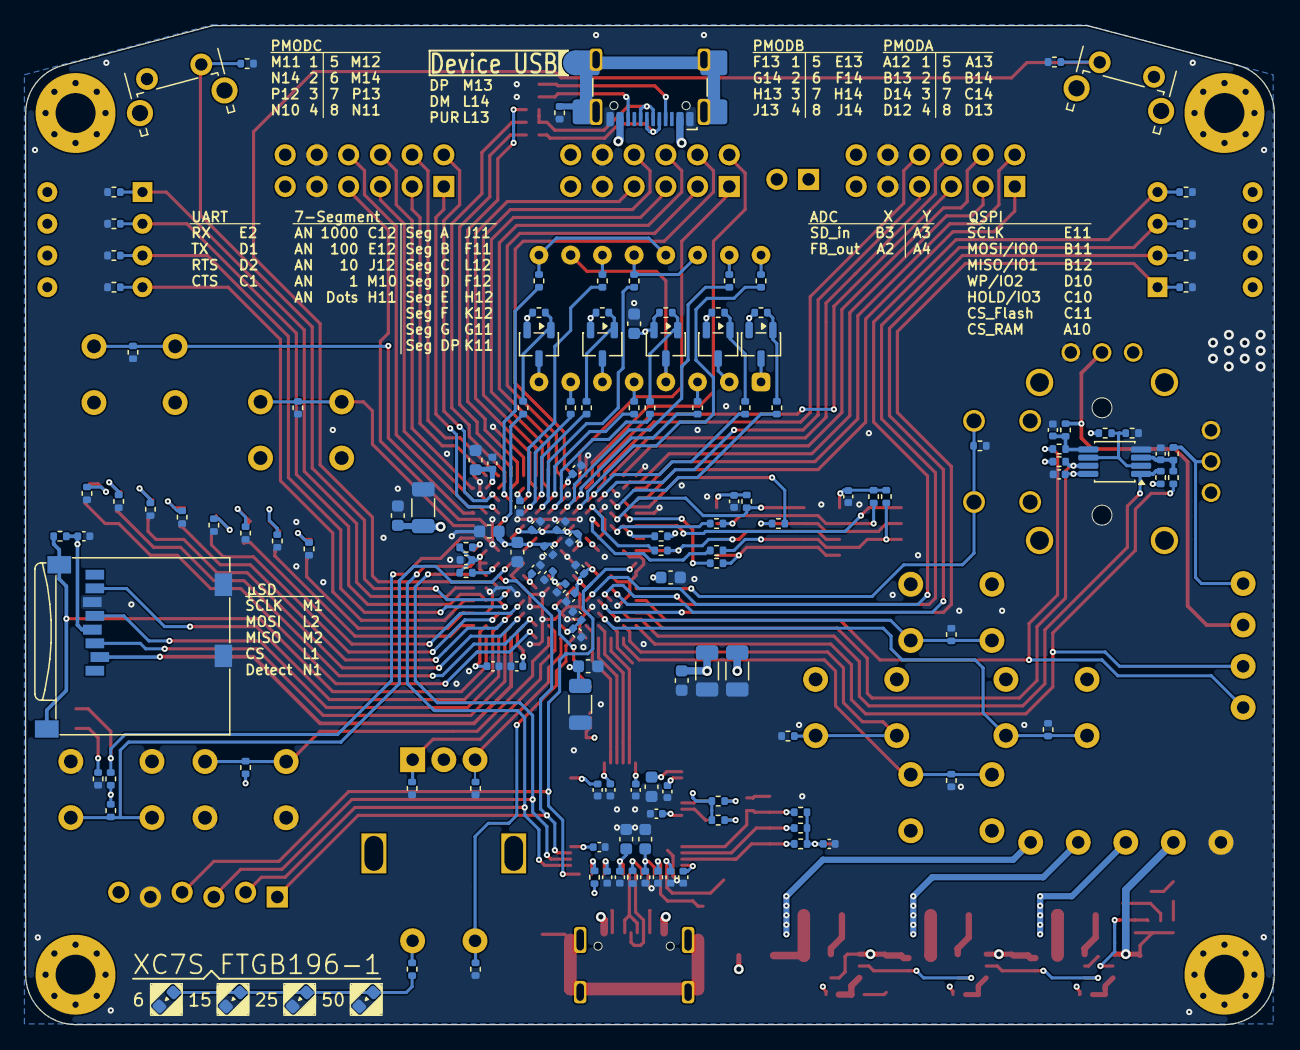
[picture p36: board FPGA-Devel.kicad_pcb from below]

Board: 4 copper layers, 100.0 x 80.0 mm, 231 parts (144 on the bottom side), 178 nets.
