AWenzel83/FPGA-Dev/(commit log)

2025-10-09 KiCad-Files added
    [7M-24.000MBBK-T.STEP, 804287_segment_display_10mm_clock.stp, Download_STP_482012714003 (rev1).stp, EC11E-15SW.STEP, FPGA-Devel.kicad_pcb, FPGA-Devel.kicad_sch, FPGA_Config.kicad_sch, FPGA_IO.kicad_sch]
2025-10-22 Combo-Footprint für Flash
    [FPGA-Devel.kicad_pcb]
2025-10-22 Combo-Footprint für Flash (auch im Schematic)
    [FPGA-Devel.kicad_pcb, memory.kicad_sch]
2025-10-28 kleine Layout-Anpassungen, Silkscreen korrigiert
    [FPGA-Devel.kicad_pcb]
2025-10-29 mehr kleine Layout-Anpassungen
    [FPGA-Devel.kicad_pcb]
2025-11-12 kleine Anpassungen im Silkscreen
    [FPGA-Devel.kicad_pcb, io.kicad_sch]
2025-11-18 kleine Anpassungen im Schaltplan
    [FPGA-Devel.kicad_pcb, io.kicad_sch]
2025-11-19 replaced SAR-ADC with Sigma-Delta-Converter
    [FPGA-Devel.kicad_pcb, FPGA_IO.kicad_sch, adc.kicad_sch, ft2232.kicad_sch, io.kicad_sch]
2026-03-17 Vorberitung für micro-SD
    [FPGA-Devel.kicad_pcb, FPGA-Devel_rev_1_1.ods, FPGA_IO.kicad_sch, adc.kicad_sch, io.kicad_sch]
2026-03-18 micro-SD hinzugefügt
    [Download_STP_693071010811 (rev1).stp, FPGA-Devel.kicad_pcb, FPGA-Devel.kicad_sch, FPGA_IO.kicad_sch, fpga.kicad_sch, memory.kicad_sch]
2026-03-19 Pinout und Silkscreen angepasst
    [FPGA-Devel.kicad_pcb, FPGA-Devel.kicad_sch, FPGA_IO.kicad_sch, adc.kicad_sch, ft2232.kicad_sch, memory.kicad_sch]
2026-03-24 Update auf KiCad 10
    [FPGA-Devel.kicad_pcb, FPGA-Devel.kicad_sch, FPGA_Config.kicad_sch, FPGA_IO.kicad_sch, FPGA_Power.kicad_sch, adc.kicad_sch, conn.kicad_sch, fpga.kicad_sch]
2026-03-24 Step-Files angepasst, Logo hinzugefügt
    [418117270904 (rev1).stp, 430156043736 (rev1).stp, FPGA-Devel.kicad_pcb, MicroSD_Card.step, RKJXV122400R.STEP, RKJXV122400R_gray.STEP]
2026-03-24 Vergessen die Polygone neu zeichnen zu lassen...
    [FPGA-Devel.kicad_pcb]
2026-04-13 LEDs zur Visualisierung des ausgewählten FPGAs
    [FPGA-Devel.kicad_pcb, FPGA_Config.kicad_sch, FPGA_IO.kicad_sch, MicroSD_Card.step, adc.kicad_sch, ft2232.kicad_sch, io.kicad_sch, memory.kicad_sch]
2026-04-17 JTAG-Verbinder hinzugefügt
    [Download_STP_490107670612 (rev1).stp, FPGA-Devel.kicad_pcb, FPGA_Config.kicad_sch]
2026-05-18 minor touches
    [FPGA-Devel.kicad_pcb, adc.kicad_sch]
2026-06-23 Prepare v1.2
    [FPGA-Devel-B_Cu.gbr, FPGA-Devel-B_Mask.gbr, FPGA-Devel-B_Paste.gbr, FPGA-Devel-B_Silkscreen.gbr, FPGA-Devel-Edge_Cuts.gbr, FPGA-Devel-F_Cu.gbr, FPGA-Devel-F_Mask.gbr, FPGA-Devel-F_Paste.gbr]
